weiszpal/fpga-floppy/README.md

# fpga-floppy
FPGA interface board to use an IBM PC floppy disk drive as any C64 comatible FDD
