weiszpal/fpga-floppy/beszamolo/appendices.tex

%----------------------------------------------------------------------------
\appendix
%----------------------------------------------------------------------------
\chapter*{Függelék}\addcontentsline{toc}{chapter}{Függelék}
\setcounter{chapter}{6}  % a fofejezet-szamlalo az angol ABC 6. betuje (F) lesz
\setcounter{equation}{0} % a fofejezet-szamlalo az angol ABC 6. betuje (F) lesz
\numberwithin{equation}{section}
\numberwithin{figure}{section}
\numberwithin{lstlisting}{section}
%\numberwithin{tabular}{section}

\section{Az eredeti 1581-es floppy meghajtó kapcsolási rajza}
\includepdf[pages=-,angle=90]{appendices/1581_schematic.pdf}

\includepdf[pages=1,angle=90, offset=0 -25, pagecommand={\section{Az interfészkártya kapcsolási rajza}}]{appendices/interface_board.pdf}
\includepdf[pages=2-,angle=90, offset=0 -25]{appendices/interface_board.pdf}

\includepdf[pages={-}, nup=1x2, scale=.8, pagecommand={\section{Az interfészkártya NYÁK-terve}}]{appendices/pcb.pdf}
