weiszpal/fpga-floppy/beszamolo/diploma.pdf

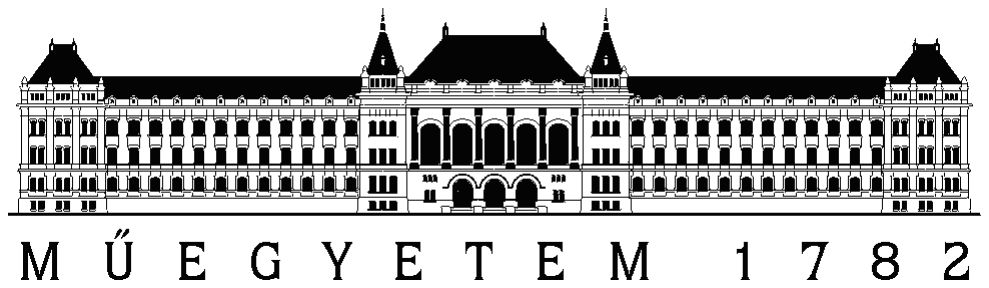
[picture p11: figure]

Budapesti M ˝uszaki és Gazdaságtudományi Egyetem Villamosmérnöki és Informatikai Kar Méréstechnika és Információs Rendszerek Tanszék

# Commodore floppy meghajtó megvalósítása FPGA-val

MSc Önall ´ o laborat ´ | orium ´ | 2.
Készítette | Konzulens
Weisz Pál | Horváth Kristóf

2022. december 18.

Feladatkiírás

A hallgató feladata, hogy egy Commodore számítógépekhez készült floppy meghajtó egységet valósítson meg FPGA segítségével. A munka magába foglalja az eredeti hardver megismerését és annak áttervezését úgy, hogy azt az interfészáramköröket leszámítva meg lehessen valósítani modern technológiák felhasználásával. Cél még, hogy kész rendszer képes legyen valódi (azaz nem virtuális) floppy lemezek kezelésére egy PC floppy meghajtó felhasználásával.

# Tartalomjegyzék

1. Bevezet˝o | 3
2. A hardver | 8
3. Digitális tervezés | 10
4. Tesztelés, hibajavítás | 16
Irodalomjegyzék | 21
Függelék | 22

# 1. fejezet

# Bevezet˝o

### 1.1. A feladat összefoglalása

Cél tehát, hogy egy szabványos IBM PC floppy meghajtót felhasználva FPGA segítségével egy olyan hajlékonylemezes egységet valósítsak meg, mely Commodore-számítógépekkel kompatibilis és a hozzájuk való floppy-lemezeket írni-olvasni képes.
Az önálló laboratórium alatt végzett munkám során egy Commodore 1581 típusú, 3,5"-es lemezmeghajtó prototípusát készítettem el ily módon. A kit˝uzött cél megvalósításához felkutattam ez eredeti meghajtó kapcsolási rajzát, szervizkönyvét, elolvastam a konstrukcióban alkalmazott alkatrészek adatlapjait. Megismerkedtem a Commodore számítógépes környezetben alkalmazott perifériák, interfészek szabványaival, m˝uködésével is. Ezek alapján, valamint az általam használt FPGA-fejleszt˝opanel és PC-s meghajtó jelszintjeinek, tulajdonságainak figyelembe vételével megterveztem egy interfészpanelt, mely az alaplapi vezérl˝o logikát implementáló FPGA-t illeszti a fizikai környezetéhez, vagyis a meghajtó hardveregységéhez és a számítógéppel való kapcsolatot biztosító soros porthoz.
Az eredeti 1581-es vezérlését egy komplett mikroprocesszoros rendszer látja el, melyet - funkcionalitását tekintve - egy az egyben az FPGA-n szintetizálva valósítottam meg. Az ehhez szükséges verilog-modulok egy részét korábbi projektekb˝ol emeltem át, a hiányzóakat pedig én magam implementáltam.
A rendszert el˝oször modulonként, majd különböz˝o integráltsági szinteken is teszteltem, el˝oször a Xilinx ISE szimulációs környezetében, majd pedig logikai analizátorral a kész hardveren is. Az FPGA-n megvalósított rendszer alkalmas az eredeti 1581-es firmware-ének futtatására, mely bináris állomány formájában rendelkezésemre állt. A kezdeti sikeres integrációs teszteket követ˝oen processzor bels˝o állapotát nagyon körülményessé vált vizsgálni, és mivel a rendszer egy ponton érzékelhet˝oen hibára futott, másféle megközelítéssel próbálkoztam: írtam egy emulátorprogramot, mely segítségével sikerült meghatároznom és kijavítanom a készként átvett CPU implementáció hibáját. További teszteket követ˝oen számos egyéb hibát derítettem fel és javítottam ki. A félév végeztével sikerül elérnem, hogy a meghajtó képes legyen hibamentesen kommunikálni soros porton keresztül a valódi Commodore számítógéppel.

### 1.2. Rendszerterv

Els˝o lépés az irodalomkutatás volt, valamint az elinduláshoz szükséges információk összegy˝ujtése. Az eredeti meghajtó áttervezéséhez nélkülözhetetlen megismerni, hogyan m˝uködik, milyen részekb˝ol épül fel az eszköz - ebben nagy segítségemre voltak a nyilvánosan elérhet˝o dokumentációk, kézikönyvek.[11] Azért esett a választás épp a Commodore 1581 típusú floppy meghajtóra, mert ez ma is többé-kevésbé elérhet˝o kis méret˝u 3.5"-es hajlékonylemezeket használ, bels˝o felépítését tekintve pedig jól elkülöníthet˝o részekre dekomponálható, szemben például a 1541-essel.

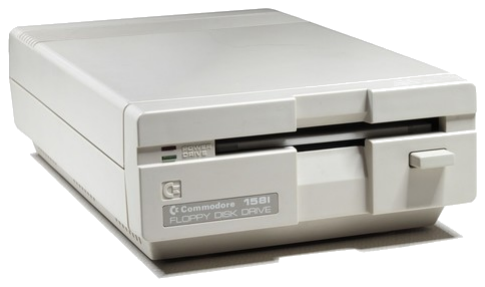
[picture p12: figure]

### 1.1. ábra. A Commodore 1581 típusú hajlékonylemezes meghajtó

A Commodore 1581-es meghajtó tulajdonképpen maga is egy "számítógép", hiszen a kiszolgálni kívánt számítógéppel való kommunikációt, és magát a lemezkezelést egy, a meghajtó alaplapján található diszkrét integrált áramköri elemekb˝ol felépített processzoros rendszer végzi. A 1581-es és a számítógép közötti kommunikáció egy Commodore IEEE-488 szabványú soros buszon zajlik.[20] A floppy lemezhez fizikailag egy bels˝o író-olvasó egység segítségével lehetséges hozzáférni, mely egyébként szabványos, Amiga számítógépeknél is használatos ún. Shugart-interfésszel rendelkezik.[5] Ezzel szemben az általam megtervezett rendszerben a floppy író-olvasó egységet egy mai modern asztali IBM PC-vel kompatibilis floppy meghajtóval helyettesítettem, mivel ilyen berendezéseket ma sem lehetetlen beszerezni, szemben az eredeti konstrukcióban alkalmazott típusúval.

A szervizkönyv mellékleteként megtalálható a meghajtó eredeti kapcsolási rajza is, melyet a további tervezéshez az alábbi részekre bontottam:

- Soros port: a soros busz meghajtását és leválasztását szolgáló áramköri elemek
- Floppy interfész: a PC floppy meghajtó illesztéséhez szükséges bufferek, inverterek
- FPGA: az egész processzoros környezetet és minden más integrált áramköri elemet a szükséges kiegészít˝o logikákkal együtt ezen fogok megvalósítani

Így jól elkülöníthet˝ové váltak azok a részek, melyekhez kiegészít˝o áramkör fizikai elkészítése szükséges az egyes protokollok tulajdonságainak ismeretében.

### 1.3. Protokollok

Következ˝o feladat annak az el˝okészítése volt, hogy az itt ismeretetett protokollokon szabványos módon történjen kommunikáció az alaplap és a PC floppy-meghajtó, valamint a számítógép között.

### 1.3.1. A Commodore IEEE-488 soros busz

A 8-bites Commodore asztali számítógépek az ún. Commodore IEEE-488 soros busz (vagy röviden IEC-busz) segítségével kommunikálnak a hozzájuk kapcsolt f˝obb perifériákkal, jellemz˝oen nyomtatókkal vagy mágneses adathordozó alapú háttértárakkal. Eredetileg az IEEE-488 szabványból alakították ki a költségek csökkentése végett (innen az elnevezése). Ez alapvet˝oen egy fél-duplex szinkron soros adatátviteli interfész, viszont számos speciális megoldást alkalmaz a szabvány pl. handshake vagy a buszra kapcsolódó eszközök jelenlét-érzékelésének megvalósítására.[20]

### 1.1. táblázat. Az IEC-busz jelei

Pin | Jelölés | Funkció
1 2 3 4 5 6 | SRQ GND ATN CLK DATA RESET | Service Request In Ground Serial Attention In/Out Serial Clock In/Out Serial Data In/out Serial Reset

Alacsony-aktív, nyitott kollektoros meghajtású vonalak ezek, 5V-os logikai jelszinttel. A számítógépez csatlakoztatott eszközöknek saját maguknak kell gondoskodniuk a tápellátásukról. Az egyes adatvonalakat mindkét végükön felhúzó ellenállások zárják le, a buszt nyitott kollektoros inverterek hajtják meg. Csatlakozó gyanánt 6 lábú DIN dugót alkalmaznak.
A soros buszra több eszköz is csatlakozhat, ezeket fizikailag daisy-chainelve lehetséges összekapcsolni egymással és a számítógéppel, emiatt szokásosan két csatlakozót építenek ki az egyes perifériákra. Az egyes eszközöket azonosítójuk alapján képes megcímezni a számítógép. Az adott azonosító DIP kapcsolók segítségével hardveresen konfigurálható, mely lemezmeghajtók esetén tipikusan 8 és 11 közötti egész értéket vehet fel.
A kommunikáció egységei 8-bites adatcsomagok, melyekben a legkisebb helyi érték˝u bit található az els˝o helyen. A mintavételezés szinkron módon, a CLK jel felfutó élére történik. Ezek az adatcsomagok lehetnek vezérl˝o parancsok, vagy adatok. Vezérl˝o parancsokkal lehet a busz használatára vagy elengedésére utasítani az egyes perifériákat, vagy épp valamilyen irányú adatátvitelt kezdeményezni a megcímzett eszközzel. A vezérl˝o parancsok a buszon az ATN jel alacsony szintje mellett érkeznek mégpedig kizárólag a számítógép fel˝ol, innen lehet tudni, hogy nem egy általános adat átvitele történik.
A CLK és DATA vonalak kétirányúak, ezeket a floppy meghajtó is lehúzhatja. Ilyen módon jelzi a számítógépnek, hogy készen áll az adat fogadására vagy küldésére, de például bizonyos id˝okorláttal kiegészített nyugtázásra is használja ezt a módszert a szabvány.[6]

### 1.3.2. Floppy meghajtó

A feladat egyik nehézségét az adta, hogy a 1581-es meghajtó eredetileg másfajta floppy íróolvasót tartalmazott, mint amilyeneket az IBM-kompatibilis személyi számítógépekben használtak, használnak. Ez nem is a m˝uködési módjukban, sokkal inkább az IBM PC és a Shugart interfészek közti különbségben nyilvánul meg:[16]

1.2. táblázat. IBM/PC és Shugart interfésszel rendelkez˝o hajlékonylemez-meghajtók lábkiosztása

IBM/PC
Pin | Jelölés | Funkció
2 | REDWC | Density Select
4 | n/c | Reserved
6 | n/c | Reserved
8 | INDEX | Index
10 | MOTEA | Motor Enable A
12 | DRVSB | Drive Select B
14 | DRVSA | Drive Select A
16 | MOTEB | Motor Enable B
18 | DIR | Direction
20 | STEP | Step
22 | WDATE | Write Data
24 | WGATE | Write Enable
26 | TRK00 | Track 0
28 | WPT | Write Protect
30 | RDATA | Read Data
32 | SIDE1 | Head Select
34 | DSKCHG | Disk Change

Shugart
Pin | Jelölés | Funkció
2 | DCD | Disk Change Detect
4 | key | no pin in this position
6 | DS3 | Drive Select 3
8 | INDEX | Index
10 | DS0 | Drive Select 0
12 | DS1 | Drive Select 1
14 | DS2 | Drive Select 2
16 | MTRON | Motor On
18 | DIR | Direction
20 | STEP | Step
22 | WDATE | Write Data
24 | WGATE | Write Enable
26 | TRK00 | Track 0
28 | WPT | Write Protect
30 | RDATA | Read Data
32 | SIDE1 | Side Select
34 | RDY | Ready

Nem tüntettem fel a táblázatban, de mindenképp érdemes megjegyezni, hogy minden páratlan számú lábat a földre kötnek. Mivel a gyakorlatban szalagkábelen szokás továbbítani ezeket a jeleket, zavarvédelem szempontjából el˝onyös, ha az áthallás csökkentése végett nem jelvezetékek haladnak közvetlenül egymás mellett, hanem felváltva követik egymást a földvezetékekkel.
Hasonlóan a soros porthoz, mindkét fajta interfész esetén is 5V-os, open kollektoros meghajtású alacsony aktív jelekkel lehet találkozni, viszont nem el˝oírás, hogy az eszköz tartalmazza a felhúzó ellenállásokat. Ezek PC esetén a számítógépben, jelen megoldásban pedig a 1581-es meghajtó alaplapján találhatóak.
Megfigyelhet˝o, hogy a jelek többsége megfeleltethet˝o egymásnak.[2] PC esetén egy szalagkábelre két meghajtó kapcsolható, ezeket az A és B kiválasztójelek segítségével lehet megkülönböztetni egymástól, míg a Shugart interfészen akár 4 különböz˝o eszköz is kiválasztható a DS jelek megfelel˝ojének földre húzásával.
Szembet˝un˝o különbség ezen kívül még, hogy a Disk Change jel máshol van kivezetve a két esetben, a Density Select valamint a Ready jeleknek pedig nincs megfelel˝oje a másik csatlakozón.
A Density Select jellel kapcsolatban egymásnak ellentmondó információkat találtam kutatásom során, valahol kimenetként, máshol bemenetként használják, de mindenképp a meghajtóban használt floppy lemez adats˝ur˝uségével hozható kapcsolatba. Ennek oka, hogy fizikailag máshogy kell kezelni egy SD, egy DD vagy egy HD hajlékonylemezt.

Korszer˝u meghajtók ezt az adathordozó tokján található kivágás segítségével érzékelik, régi fajta (és f˝oleg 5.25"-es) meghajtók esetén viszont ezzel a Density Select jellel írható el˝o, milyen adatsebességgel dolgozzon a meghajtó vezérl˝oje. Az általam használt PC floppy meghajtóban például ez a jel nincs is kivezetve.[15]
A Ready jel el˝oállításához mindenképp kiegészít˝o logika megtervezése kellett, mivel a 1581-es kapcsolási rajza szerint szükség van rá. Az eredeti író-olvasó egység adatlapja alapján ez a jel akkor aktív, ha van lemez a meghajtóban és emellett megfelel˝o sebességgel forog a motor.[3] Ha forog a motor, fordulatonként egy impulzus mérhet˝o az Index jelen. Az általam használt PC-s meghajtóban ez az impulzussorozat kapuzva van, és csak akkor kerül ki a kimenetre, miután a motor elérte a megfelel˝o fordulatszámot. Ennek a felhasználásával el˝oállítható a Ready jel, hiszen hardveresen biztosított, hogy a motor csak akkor forog, ha van a meghajtóban lemez.
A Commodore 1581-es meghajtó két oldalú, 800kB kapacitású kétszeres adats˝ur˝uség˝u (double-density, DD) lemezek kezelésére alkalmas. Az így formázott lemez oldalanként 80 sávot és 10 szektort tartalmaz fizikailag, a biteket MFM kódolással tárolja a rendszer. Mivel az így formázott lemez nem IBM kompatibilis, így a mai asztali számítógépekkel nem értelmezhet˝o a tartalma. A feladatban használt PC floppy meghajtó reményeim szerint mégis tudja kezelni, hiszen az valójában csak alacsony szint˝u hozzáférést biztosít a lemezhez, a rajta lév˝o adatok feldolgozásáról az alaplapi processzoros rendszer gondoskodik.

# 2. fejezet

# A hardver

### 2.1. Bemutatom a fejleszt˝okártyát

A feladat megoldásához egy X-SP6-X9 jelzés˝u Xilinx Spartan 6 alapú FPGA-fejleszt˝okártya állt rendelkezésemre. Számos szabadon felhasználható és széleskör˝uen konfigurálható IO kivezetésén kívül el˝onye, hogy tartalmazza az általános célú fejlesztésekhez szükséges perifériákat, nyomógombokat, kapcsolókat, LED-eket. Küls˝o JTAG programozóval tölthet˝o fel rá a bitstream, de egy 16MB-os SPI flash is helyet kapott, melyr˝ol szintén elvégezhet˝o a konfiguráció. 5V-os tápellátással rendelkezik, viszont az IO lábak 3.3V-nak megfelel˝o CMOS logikai jelszinttel dolgoznak.

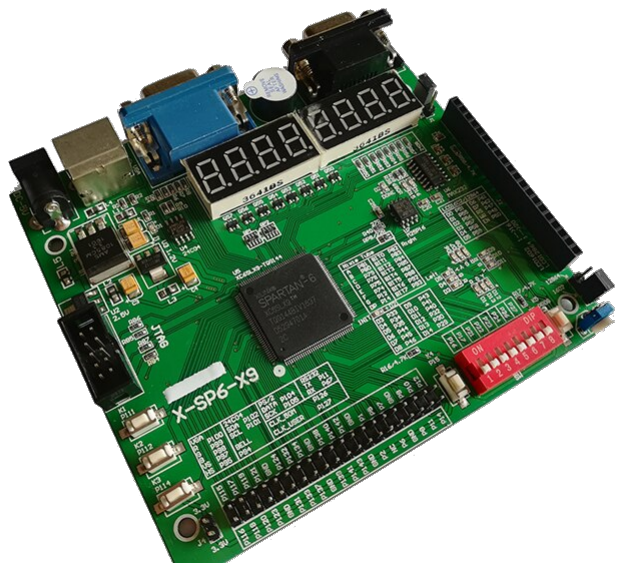
[picture p13: figure]

### 2.1. ábra. Illusztráció a megoldáshoz használt FPGA-fejleszt˝opanelr˝ol

Mivel a soros busz és az író-olvasó egységként szolgáló PC floppy meghajtó eltér˝o logikai jelszinteket használ, mint az FPGA, így mindenképp szükséges a valóságban realizálni egy szintilleszt˝o áramkört. Ezt egy interfészpanel formájában terveztem és valósítottam meg.

### 2.2. Az interfészpanel

Már a 1581-es kapcsolási rajzában is látható, hogy mind a soros port, mind a lemezmeghajtó esetén is meghajtófokozatokat, nyitott kollektoros buffereket vagy invertereket alkalmaztak, 1kΩ-os felhúzó ellenállásokkal kiegészítve. Ezeket az áramköri elemeket a szintillesztésre való tekintettel a valóságban is realizálnom kellett.
Az interfészpanel tervezésekor az eredeti terveknek megfelel˝o tulajdonságú integrált áramköri alkatrészeket választottam azzal a kritériummal kiegészítve, hogy a szükséges jelszint-illesztési feladatot is képesek legyenek ellátni. Gazdaságossági okokból, valamint az áramkör egyszer˝usítése végett az összes kimeneti vonalat 74LS06 típusú nyitott kollektoros inverterrel, a bemenetieket 5V toleráns bemenet˝u 74LVC14 típusú CMOS inverterrel kapcsoltam a rendszerhez. Ebb˝ol a megoldásból ugyan az következik, hogy az eredeti kapcsolással ellentétben néhány jel így invertáltan áll rendelkezésre, de ezek visszaállítását az FPGA-n megvalósított rendszer implementálásakor figyelembe vettem.
Az illeszt˝o áramkör kapcsolási rajza nem bonyolult, külön vettem rajta a soros porthoz és a floppy meghajtóhoz tartozó részeket, valamint helyet kapott rajta az eredeti 1581-es el˝olapján megtalálható két státuszjelz˝o LED is. Az eredeti kapcsolási rajznak megfelel˝oen a soros port kétirányú jeleit is különválasztottam.
Az áramkörnek két tápfeszültségre van szüksége, egy 3.3V-osra, és egy 5V-osra, mindkett˝ot az FPGA-fejleszt˝opanelr˝ol biztosítottam. Ehhez rendelkezésemre állt a fejleszt˝opanel kapcsolási rajza és lábkiosztása. A nyomtatott áramkört úgy terveztem meg, hogy közvetlenül illeszkedjen az FPGA-panel tüskesoraira. A huzalozás és a lábkiosztás megtervezésekor törekedtem arra, hogy a lehet˝o legkevesebb keresztez˝odéssel elférjenek egymás mellett a vezet˝osávok. Ergonómiai szempontokat is figyelembe vettem a tervezés során, hogy az FPGA-kártya kialakításának megfelel˝oen maradjon hely a programozó csatlakozó, a meghajtó azonosítójának beállítására használt DIP kapcsolók és a RESET gomb számára, és ne takarja el az interfészpanel ezeket a felületeket, miközben rajta van. Hasonlóképp helyeztem el a floppy meghajtó csatlakoztatására szolgáló IDC csatlakozót és a soros port számára a 6 lábú Tuchel aljzatot. A mechanikai kialakításkor nehézséget okozott, hogy nem volt pontos m˝uszaki rajz az FPGA-panel oldalsó tüskesorának pontos helyér˝ol, így azt becslés alapján tudtam csak pozicionálni, ez elég pontosan sikerült is.

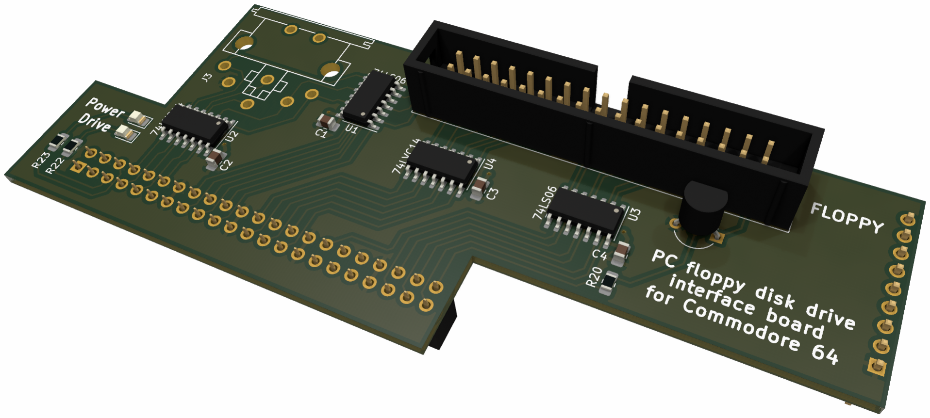
[picture p14: figure]

### 2.2. ábra. A saját tervezés˝u interfészpanel 3D terve

# 3. fejezet

# Digitális tervezés

Az FPGA-ra a Xilinx ISE 14.3-as verzójú fejleszt˝oi környezetének segítségével fejlesztettem a rendszert. Ez nem egy kimondottan korszer˝u ám szerencsére hibamentes szoftver. Azért ezt használtam mégis, mert a Spartan 6-os FPGA-kat a szoftver korszer˝u alternatívája (a Vivado) már nem támogatja. A leírófájlokat, modulokat és testbench-eket Verilog nyelven készítettem el, viszont helyenként szükséges volt VHDL-ben implementált részekkel is foglalkoznom kés˝obb a hibakeresés során.

### 3.1. Modulok

A 1581-es meghajtót egy MOS 6502 típusú processzoron futó operációs rendszer irányítja. Az alaplapon megtalálható a firmware bináris állományát tartalmazó 32kB ROM és 8kB RAM. A perifériák illesztését egy 8520-as komplex interfész adapter (CIA), a lemez író-olvasó egység vezérlését egy WD1772 típusú floppy meghajtó vezérl˝o (FDC) integrált áramkör végzi. Ezek képezik a f˝obb logikai egységeket, így kézenfekv˝o volt modulba szervezni ˝oket, és így beilleszteni a projektbe.

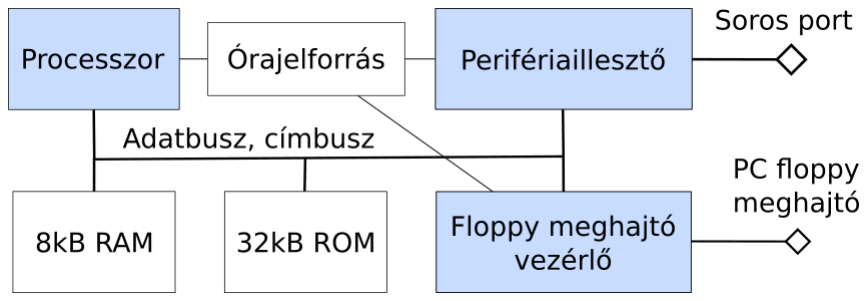
[picture p15: figure]

### 3.1. ábra. Az FPGA-n megvalósított rendszer sematikus rajza

Korábbi projektek eredményét felhasználva rendelkezésemre álltak a CPU, a CIA és az FDC implementációi, ezeket átvettem, esetenként továbbfejlesztettem munkám során. Az órajel-generátort, a RAM és ROM modulokat én készítettem el.
A rendszer 8-bites adatbuszt és 16 bites címbuszt használ, 2MHz-es rendszerórajelr˝ol jár minden a floppy vezérl˝o kivételével, mely 8MHz-es órajelet igényel. Ezen órajelek el˝oállítása egy 4-bites számlálóval történt eredetileg, egy 16MHz-es oszcillátor jelének leosztásával. Érdekesség, hogy az ehhez alkalmazott 74LS93-as IC konfigurálható bitszámú: 3 vagy 4 bites számlálót is lehetséges kialakítani a segítségével. Egy ebben a témában végzett korábbi próbálkozás során a nem megfelel˝o konfiguráció jelenthetett hibalehet˝oséget.
Az eredeti kapcsolásban az egyes logikai egységekhez tartozó címdekódolást és engedélyez˝o jelek el˝oállítását kombinációs hálózattal kiegészített multiplexerek végzik, a memóriatérkép az alábbiak szerint alakul:

### 3.1. táblázat. Az 1581-es meghajtó processzoros rendszerének címtartomány-kiosztása

Eszköz | Címtartomány
RAM CIA FDC ROM | 0x0000 - 0x1FFF 0x4000 - 0x400F 0x6000 - 0x6003 0x8000 - 0xFFFF

A címdekóder leírása verilogban:

assign CSn_RAM = addr [15:13]!=3 ’ b000; | //address range: $0000 -$1FFF (U6)
assign CSn_ROM = !(rw && addr [15]); | //address range: $8000 -$FFFF (U7)
assign CSn_CIA = addr [15:13]!=3 ’ b010; | //address range: $4000 (U6)
assign CSn_FDC = !( addr [15:13]==3 ’ b011 ); | //address range: $6000 (U6)

Mivel 1581-es meghajtóban gyakran használnak nyitott kollektoros meghajtású logikai
elemeket, így kézenfekv˝o, hogy a felhasznált logikai kapuk számának csökkentése végett
huzalozott módon valósítsanak meg bizonyos logikai függvényeket. Erre az FPGA-n technológiai okokból nincs lehet˝oség, ezért a huzalozott logikájú részeket átterveztem, hogy logikai kapukkal is le lehessen azokat írni.


3.2. ábra. Részlet az eredeti meghajtó kapcsolási rajzából.

Huzalozott logikai kapcsolat megvalósítása a soros busz DATA vezetékén, és a neki megfelel˝o verilog-leírás:

assign DATA_OUT = (∼SP_OUT) || DATA_OUT_AUX || (ATN_IN && ATN_ACK );

Bizonyos VHDL modulok implementációjában el˝ofordult, hogy kétirányúként definiáltak jeleket, például az adatbusz esetén. Ennek használata nem szerencsés, mert bár a valóságban tényleg kétirányú ugyanaz a vonal, az FPGA-ra két különböz˝o irányú jelvezetékként szintetizálódik, ezért a könnyebb érthet˝oség és a többi modullal való kompatibilitás kedvéért már a leírófájlban szétbontottam két különböz˝o vezetékre. Hasonlóképp el˝ofordult ennek a fordítottja is, amikor az eredeti kapcsolás tartalmazott kétirányú adatforgalom szétválasztására használt multiplexert, melyet így el lehetett hagyni az implementációban.

### 3.2. CPU

A 6502-es CPU egy NMOS technológiával készült 8-bites processzor. Adatbusza 8 bites, címbusza 16 bites, így összesen 64kB memóriát képes megcímezni. Kevés bels˝o regisztere van: egy akkumulátor (A), két indexregiszter (X és Y) melyek különböz˝o címzési módokhoz, címeltolásra is felhasználhatók, egy stack pointer (S) egy állapotregiszter (P), és egy 16-bites programszámláló (PC). A memória (virtuálisan) 256-bájtos blokkokba, lapokba van szervezve.
A stack hardveresen rögzített helyen, az els˝o lapon, a 0x0100-as memóriacímt˝ol kezd˝odik, és 0x01FF-ig tart. Külön figyelmet érdemel még a 0x00-s memórialap (zero-page) mely gyorsabban hozzáférhet˝o, ha a parancsok dedikált címzési módú verziójával érjük el az ott tárolt változókat. Az állapotregiszter bitjei flag-ek, logikai és aritmetikai m˝uveletek eredményeivel kapcsolatos tulajdonságokat jeleznek, a szokásos el˝ojel- (N), nulla- (Z), átvitel- (C) és túlcsordulás (V) biteken kívül tartalmaz egy BCD aritmetikát
(D) és megszakításokat engedélyez˝o bitet (I), valamint egy szoftveres megszakításkérés jelzésére szolgáló flag-et is (B). A reset vektor a 0xFFFC 0xFFFD címeken található, a megszakításvektor pedig a 0xFFFE 0xFFFF címeken - ezekr˝ol a helyekr˝ol tölt˝odik be a programszámláló értéke a processzor indulásakor, illetve megszakításkérés esetén.[17] Az eredeti 6502-es processzor a ϕ0 bemeneti órajelb˝ol két másik, fázisban egymáshoz képest 90°-kal eltolt és egymással nem átlapolódó órajelet állít el˝o a rendszer többi része számára. Ezek közül a ϕ2-t használja csak az eredeti terv alapján a meghajtó, mely az eredeti órajellel megegyez˝o fázisú.
A processzor implementációját többször lecseréltem a fejlesztés során. El˝oször az eredeti MOS 6502-es processzor tranzisztor-szint˝u felépítése alapján generált verilog-modullal próbálkoztam.[10] Sajnos az automatikusan generált leírófájl monolitikus felépítés˝u és gyakorlatilag átláthatatlan, így mivel eleinte nem sikerült m˝uködésre bírni és a bels˝o jelek vizsgálata nagyon körülményesnek bizonyult, hamar lecseréltem az Arlet Ottensféle verilog-6502 core-ra.[14] Ez az implementáció az eredetivel ellentétben az FPGA-n való megvalósíthatóság és a szemléletes m˝uködés kedvéért mikroprogramozott architektúrájú, a benne található állapotgép ráadásul aszinkron m˝uködés˝u. Ebb˝ol adódóan egy speciális, impulzusszer˝u órajelet igényel, hogy a processzormag mikro-utasításai biztosan le tudjanak futni az adott órajelciklusban. Technológiai megfontolásból FPGA-s rendszereken alapvet˝oen szinkron logikai hálózatokat érdemes megvalósítani, így konzulensem javaslatára elvetettem ezt a megoldást is, és a fejleszt˝ok körében gyakran alkalmazott T-65 nev˝u 6502 processzormag-implementációt használtam a továbbiakban.[8]
Ez a modul több kimenettel is rendelkezik, mint a 6502-es processzor, a nem használt jeleket bekötetlenül hagytam. Amelyik bemeneteket a kapcsolási rajz szerint az 5V-os tápfeszültségre kell felhúzni, azokat egész egyszer˝uen logikai magas szintre kötöttem.

### 3.3. CIA

A 8520-as komplex interfész adapter (Complex Interface Adapter, CIA) IC két 8-bites IO portot, két 16-bites id˝ozít˝ot, egy valós idej˝u órát és egy dedikált soros port perifériát tartalmaz. A 1581-es alaplapján a CIA az egyedüli periféria, mely képes megszakításokat kérni, ha valamelyik id˝ozít˝oje lejár vagy valamilyen esemény következik be a nagy sebesség˝u soros porton. A megszakításkérés egyenként engedélyezhet˝o, valamint a megszakítás forrása is lekérdezhet˝o a CIA megszakításvezérl˝o regisztere segítségével. Hasonlóképp konfigurálhatók az id˝ozít˝ok, a valós idej˝u óra, és a két IO port paraméterei. A CIA A és B jel˝u IO portjaira csatlakoznak az eszköz azonosítóját kiválasztó DIP kapcsolók, a visszajelz˝o LED-ek, valamint a soros busz jelei, irány szerint különválasztva. A csak bemenetként használt lábakra visszavezettem ugyanazon láb kimeneti irányú jelének értékét, hogy egy esetleges visszaolvasáskor jelen legyen rajta a valóságnak megfelel˝o logikai érték. Érdekesség, hogy az IEC-busz jeleit az általános IO lábak segítségével is meg tudja hajtani, s˝ot alapvet˝oen a 1581-es meghajtó ezt is használja az egyébként nagyobb sebesség˝u dedikált soros periféria helyett. Ennek történelmi okai vannak, a Commodore 64-es számítógép egy tervezési hibából adódóan nem képes olyan gyorsan feldolgozni a nagysebesség˝u soros porttal küldött adatot, ahogyan az ki tudná szolgálni. Kés˝obb ezt javították, és a Commodore 128-as számítógép esetén már a soros busz SRQ jele szolgált (az eredeti specifikációtól eltér˝oen soros órajelként) a gyors átviteli protokoll használatának kiegészítésére.[4]
A valós idej˝u órát nem az eredeti rendeltetési céljának megfelel˝oen használja a meghajtó, viszont kés˝obb a firmware-rel való ismerkedés során egy érdekes tervezési megoldásra derült fény: az alaplapot kétféle különböz˝o típusú floppy vezérl˝ovel is fel lehet szerelni, ez lehet WD1770 vagy WD1772. Az alaplapon egy átkötés beültetésével vagy elhagyásával lehet jelezni a firmware számára, melyik típusú IC szerepel a kapcsolásban, hiszen a két esetben eltér˝o rutinokat kell meghívnia a processzornak.
Mivel az összes általános célú IO láb foglalt már, a valós idej˝u órát léptet˝o TOD láb vagy egy ellenálláson keresztül 5V-ra, vagy pedig a 2MHz-es rendszerórajelre kapcsolódik az átkötés jelenlétét˝ol függ˝oen. Szoftveresen ez úgy ellen˝orizhet˝o, hogy ha egy adott idej˝u szoftveres várakozás után megváltozik a valós idej˝u óra regiszterének értéke akkor ott az átkötés, egyébként nincs.
A 8520-as CIA implementációját a C64-MiSTer elnevezés˝u projektb˝ol vettem át. Ennek lényege, hogy egy egész Commodore 64 számítógép hardverleírását tartalmazza a MiSTer nev˝u nyílt forráskódú hardverkörnyezetre, melyen többféle retro számítógép és játékkonzol modern technológiákkal (FPGA) való megvalósítására terveztek [13]

### 3.4. FDC

A hajlékonylemezes meghajtó vezérl˝o (Floppy Disk Controller, FDC) egy dedikált integrált áramkör, mely a floppy író-olvasó modul vezérl˝ojeleit állítja el˝o közvetlenül, valamint ez fogadja a lemezmeghajtóról érkez˝o nyers adatokat, visszajelzéseket is. M˝uködését tekintve egy állapotgépet valósít meg, mely szoftver oldalról magas szint˝u parancsok regiszterbe írásával vezérelhet˝o.[19]
A CIA-hoz hasonló módon, ehhez az IC-hez tartozó intellectual property-t is egy kész projektb˝ol emeltem át. A Suska projekt alapvetése, hogy egy Atari ST számítógép minden alkatrészét egyesével kicserélte a fejleszt˝o az annak megfelel˝o FPGA-s realizációjára.[9] A kapcsolási rajz alapján érdekes módon vannak a floppy meghajtónak bizonyos jelei, melyek nem, vagy nem kizárólagosan az FDC chiphez vezetnek, ilyenek például a motorvezérlés vagy az írásvédettség ellen˝orzésére szolgáló vonalak. Az is el˝ofordul, hogy egyes kimenetek egyáltalán nincsenek is bekötve az IC-n, ezeket az hardverkonfiguráció során is bekötetlenül hagytam. Abban sincs egységesség, hogy a floppy meghajtó vezérl˝ojelei közül melyik használ ponált és melyik negált logikájú digitális jeleket. Ez különös figyelmet igényelt a a top modul huzalozásakor, mivel az interfészpanelen minden jelet invertálnak a szintilleszt˝o áramkörök.
A PC-s floppy meghajtó és a meghajtóvezérl˝o IC közt némi kiegészít˝o logikára volt szükség a READY jel el˝oállításához. A Shugart-kiosztású meghajtók specifikációja alapján sejtettem, hogy a READY jel el˝oállítható egy SR-flipflop segítségével a motor engedélyez˝o és az INDEX jeleket bemenetként felhasználva. Ezt alátámasztotta az a tény, hogy léteznek kifejezetten arra a célra készült adapter-áramkörök, hogy PC-s floppy meghajtókat illesztenek Shugart-interfészt használó számítógépes rendszerbe.[18] Ezeken a kapcsolásokon egy 4 darab 2 bemenet˝u NOR kaput tartalmazó chip található, melynek m˝uködését a szabadon elérhet˝o NYÁK-tervek alapján visszafejtettem, és kideült, hogy valóban egy SR-flipflopot és két invertert valósít meg.
A READY jelet el˝oállító logikai függvény verilog-implementációja:

reg RDY;
initial RDY <= 1’b1;
always @(posedge clk) begin if(! rstn)
RDY <= 1’b1;
else begin
case({MOTEB , INDEX }) | //motor on? index?
2’b00: RDY <= 1’b1;
2’b01: RDY <= 1’b1;
2’b10: RDY <= RDY;
2’b11: RDY <= 1’b0;
endcase
end
end

### 3.5. Órajel-generátor

Az többi modulhoz szükséges órajeleket ezzel a modullal állítottam el˝o. 16MHz-es rendszerórajelet feltételeztem, melyet a floppy vezérl˝o egy az egyben megkapott, a többi modul számára az ebb˝ol leosztott 2MHz-es ϕ2 jelet adtam. A processzor implementációjából kihagyták az eredeti órajel-kondicionáló részt, mely a ϕ0-ból állítja el˝o a kétfázisú rendszerórajelet, de erre egyrészt nincs is szükség ebben a megoldásban, másrészt úgyis az órajel-generátor modul a felel˝os az összes szükséges órajel el˝oállításáért.
A frekvenciaosztást egy egyszer˝u bináris számláló végzi. Mivel az Arlet-féle processzorimplementációhoz aszimmetrikus órajelre volt szükség, így a 2MHz-es órajel-impulzusokat komparálással állítottam el˝o, és ezen a kés˝obbiekben sem módosítottam, mivel ugyanolyan jól m˝uködött.
A CIA implementációjának érdekes módon szüksége van egy invertált ϕ2 jelre is, ezt nem az órajel-modulban állítottam el˝o, hanem a bekötésnél vezettem rá az negált órajelet. A floppy vezérl˝o modul specifikációja szigorúan el˝oírja a 16MHz-es órajel használatát, mivel az FPGA-n való megvalósítás miatt bels˝o állapotgépének léptetéséhez és a vezérlésbe iktatott id˝ozítések pontos megvalósításához nagyobb frekvenciára van szükség, mint az eredeti hardver esetén.

### 3.6. Memóriák

A meghajtó eredeti kapcsolásában aszinkron RAM és ROM chipeket alkalmaztak, az adat- és címbusz meghajtását engedélyez˝o jeleket címdekóderrel állítják el˝o. Én szinkron logikai vezérléssel biztosítottam a hozzáférést mindkétfajta memóriához. A RAM és a ROM is bájtos szervezés˝u, azaz egy memóriacímmel egy bájt összes bitjéhez hozzá lehet férni. Ha olvassuk a memóriákat, akkor ezek a bitek kikerülnek az adatbuszra, ha írjuk a RAM-ot, bekerül az adatbuszon lév˝o bájt az adott cím˝u helyre.
Megvalósítás szempontjából tulajdonképpen mindkét memória egy-egy nagy regisztertömb. Arra kell külön figyelni, hogy amikor nincsenek megcímezve, ne hajtsák meg adatbuszt. Ez verilogban a Z logikai állapot használatával valósítható meg.
Mivel a ROM tárolja a 1581-es firmware-ét vagyis a CPU-n futó programot, így azt a rendszer konfigurálásakor bele kell azt valahogyan tölteni. Ehhez a $readmemh függvényt használtam, mely egy megadott helyen található bináris állományával inicializálja a paraméterként megadott regisztertömböt.
A bináris állomány rendelkezésemre állt, ugyanarról a weboldalról elérhet˝o, ahol a 1581-es szervizkönyvét is megtaláltam. Mivel a verilog hex fájlt vár a $readmemh paramétereként, át kellett alakítanom a bináris állományt a megfelel˝o formátumúra. Linux alatt a következ˝o bash-szkripttel végeztem ezt el:

for FILE in *. bin; do
hexdump -v -e ’ 1/1 "%02X\ n " ’ $FILE > ${FILE %.*}. mem; done

# 4. fejezet

# Tesztelés, hibajavítás

A feladat hátralev˝o részében az elkészült hardver-elemek tesztelésével, az esetleges hibák felderítésével és azok kijavításával foglalkoztam.

### 4.1. Az interfészpanel tesztje

Miután megérkezett a gyártásból az interfészpanel amit terveztem, elvégeztem az alkatrészek beforrasztását, és egy példaprojektet készítettem abból a célból, hogy magának a panelnek a m˝uködését ellen˝orizni tudjam. Ehhez elkészítettem az FPGA-panel tüskesorának hozzárendelését a verilog-modul jeleihez egy UCF-fájl segítségével. Az interfészpanel 5V-os jeleire egy próbapanel segítségével LED-eket illesztettem, melyeket a tesztprojektben sorban egymás után villantottam fel, így megbizonyosodhattam a szintilleszt˝o áramkör helyes m˝uködésér˝ol. Ekkor vettem észre azt is, hogy a meghajtó foglaltságát jelz˝o zöld szín˝u státusjelz˝o LED-et fordított polaritással forrasztottam rá az interfészpanelre, mivel az alkatrészen megtéveszt˝o módon szerepelt a polaritásmegjelölés - így ezt kijavítottam. A lábkiosztás megtervezésekor törekedtem arra, hogy az FPGA panel olyan lábait használjam, melyeknek nincs alternatív funkciója, ezzel csökkentve annak a valószín˝uségét, hogy a fejlesz˝opanelen található áramköri elemek vagy perifériák módosítják az áramköröm tervezett viselkedését. A teszt során nyilvánvalóvá vált, hogy az FPGA-panel specifikációjától eltér˝o módon a P11-es lábnak más funkciója is van, mégpedig az integrált soros port TX vonalát is ez táplálja. Mivel ez nincs használatban szerencsére nem okozott gondot, csak bosszantó, hogy világít az alaplapon egy extra led, valamint ezek után kevésbé megbízható dolog pusztán a dokumentációkra támaszkodni.

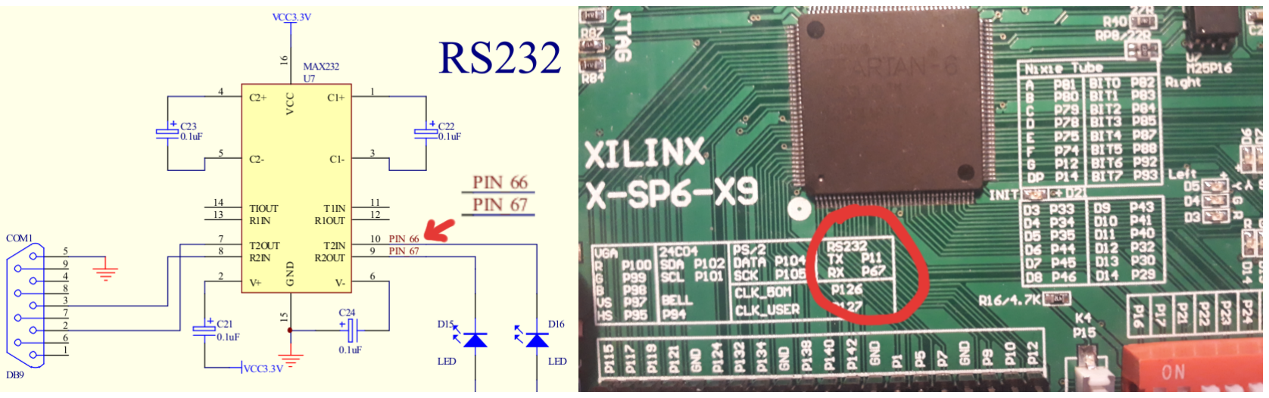
[picture p16: figure]

4.1. ábra. Eltérés a fejleszt˝opanel kapcsolási rajza és a valóság között.

### 4.2. Verilog-modulok

El˝oször a saját készítés˝u verilog-modulokhoz készítettem külön-külön tesztkörnyezeteket, és m˝uködésüket az ISE szimulátora segítségével végeztem. El˝oször az órajel-generátort, majd a memória-modulokat teszteltem, végül pedig egy olyan összeállítást is elkészítettem, ahol a RAM és a ROM is a rendszer buszaira kapcsolódik, és ellen˝oriztem az engedélyez˝o logikát valamint azt, hogy a megfelel˝o memóriacímek használatakor nem hajtanak-e szembe.
Mivel úgy t˝unt, hogy helyesen m˝uködnek ezek a modulok, elkezdtem a rendszer többi részének integrációját, egyesével vettem hozzá a projekthez a processzor, a CIA és a floppy vezérl˝o implementációjának egy-egy példányait.

### 4.3. A firmware

Miután a processzor is bekerült a top modulba, a tesztelést a ROM-ba betöltött firmware bináris segítségével végeztem: a processzor ekkor már az eredeti 1581-es meghajtóra készült kódott futtatta, így biztos lehettem benne, hogy a szoftverben nincs hiba. A bináris állományt már csak azért sem lett volna érdemes piszkálni, mivel tartalmaz egy ellen˝orz˝oösszeget is, amivel a program indulásakor a ROM tartalmának sértetlenségét ellen˝orzi. Érdekes tapasztalat volt úgy fejleszteni, hogy egy hibamentes, kész szoftver alatt kellett megvalósítani azt a hardvert, mely az eredeti specifikációnak megfelel˝o m˝uködést hivatott biztosítani.
További nehézséget jelentett, hogy magának a firmware-nek a m˝uködése csak az eredeti, assemblyben megírt forrásfájlok kommentjeib˝ol, valamint egy német nyelven kommentezett dissassembly listing fájlból volt kideríthet˝o.[7] Természetesen a 1581-es meghajtó felhasználói kézikönyvében számos információ utal arra, hogyan kell m˝uködnie bizonyos esetekben a meghajtónak, a részletes okokat csak a hardver és a firmware átfogó ismeretében lehet tudni.
A szimulátor segítségével nyomon követhet˝o volt a program futása, az FPGA-panel IO lábai mellé a processzor és a rendszer bels˝o jeleit is felvettem a megjelenített hullámformák közé, így láthatóvá váltak a buszm˝uveletek, a programszámláló és a különböz˝o regiszterek értékei is. A program futása során el˝oször különböz˝o hardveres teszteket hajt végre: inicializálja a perifériákat, leellen˝orzi a ROM sértetlenségét az ellen˝orz˝oösszeg alapján, különböz˝o értékekkel tölti fel a RAM-ot majd vissza is olvassa azokat. Az ekkor fellép˝o hibajelenségeket a hiba okától függ˝oen a visszajelz˝o LED-ek megadott számú felvillanásával lehet azonosítani.
Miután lefutottak a tesztek, elalszik a ’Drive’ feliratú státusz visszajelz˝o LED, és a firmware elindít egy operációs rendszert. Az ütemez˝ot az interfész adapter Timer B id˝ozít˝oje hívja meg, másodpercenként 100-szor. Az operációs rendszer prioritásokkal megadott JOB-okat futtat, egyszerre legfeljebb 8-at képes nyilvántartani. Futáskor a JOB kódokat a prioritásuknak megfelel˝o sorrendben fix memóriacímeken tárolja, a feladat befejezésekor pedig a visszatéréskor adott kód (hibakód) kerül a helyére.

A szimuláció kezdeti szakasza alapján m˝uködni látszott a processzor, így megpróbáltam az FPGA-ra szintetizálva is kipróbálni a rendszert. Azt tapasztaltam, hogy sosem aludt el a zöld LED, és valóban nem is jutott túl az inicializálási állapoton a meghajtó. Mivel a hardveren nem állt rendelkezésre debugolásra vagy legalábbis a program futásának nyomon követésére alkalmas interfész, visszatértem a szimulációhoz. Hosszabb ideig futtatva azt, kiderült, hogy végtelen ciklusba kerül a program és egy olyan változó értékének 0-ra csökkenésére vár, amelyet a program további futása során nem módosít semmi.
Az assembly listing alapján kiderítettem, hogy a szóban forgó változó egy szoftveres várakozáshoz használt számláló, melynek értékét az id˝ozít˝o lejártával kiszolgálásra kerül˝o megszakításrutin csökkenti eggyel. A probléma, hogy nem jut sose érvényre ez a megszakítás. Mivel a jelenség okának felderítéséhez ezen a ponton már nem volt kényelmes pusztán a szimulátor környezetben vizsgált jelek alapján kitalálni, mi okozza a program futásában fellép˝o eltérést (annak tudatában, hogy a program viszont biztosan jól m˝uködne egy hibamentes hardveren), más megközelítéssel próbálkoztam.

### 4.4. Emulátor

Az ugró utasítások és ciklusok nyomon követése nagyon megnehezítette a debugolást, mivel az ISIM programban csak lineárisan követhet˝o a program futása. Ráadásul a memória tartalma csak a szimuláció végével elért állapotot tükrözi, a kurzorok állításával nem kérdezhet˝o le a szimuláció egy korábbi id˝opontjához tartozó állapot. Emiatt a változók és a stack tartalmának vizsgálata, valamint az eltérések észrevétele csak egy újabb szimuláció segítségével volt megtehet˝o, ami viszont jelent˝osen megnövelte a hibakereséssel töltött id˝ot.
Ahhoz, hogy egyáltalán a program futásának nyomon követését hatékonyabban tudjam végezni, írtam egy emulátor programot C-ben, mely a rendszer funkcionális m˝uködésének megfelel˝oen viselkedik. Léteznek ugyan online elérhet˝o 6502-es processzorhoz készült disassembler és emulátor eszközök, melyek viszont els˝osorban demonstrációs célúak, így nem b˝ovíthet˝ok vagy fejleszthet˝ok tetsz˝olegesen. Az emulátor elkészítéséhez mindenképp szükséges volt megismernem a 6502-es processzor bels˝o felépítését és m˝uködését, utasításkészletét, címzési módjait, és hogy melyik m˝uvelet milyen egyéb bels˝o állapotokat változtat meg. Ebben segítségemre volt a 6502-es processzor programozói kézikönyve[1], valamint az utasításkészlet online példákkal kiegészített interaktívan kereshet˝o változata.[12]
Az emulátor program ugyanazt a bináris állományt futtatja, mint amit a ROM-ba is betöltöttem, s˝ot felépítését tekintve a verilog-ban leírt rendszert tükrözi azzal az eltéréssel, hogy minden perifériához mint memória fér hozzá, a róluk beolvasott értékeket pedig az olvasás pillanatában állítottam el˝o a valóságnak (és a szimulációnak) megfelel˝o módon. Az emulátor segítségével tehet˝ok a programba töréspontok, de másmilyen típusú feltétel esetén megállítható a program futása, és szemléletes módon megtekinthet˝o a stack vagy a zero-page tartalma, hasonlóképp a CPU és a többi periféria regisztereié is. A hardveres megszakítás-kéréseket szintén a szimuláció és a kiváltó okok ismeretében az emulátorban szoftveresen valósítottam meg.
Az emulátor, a listing fájl, valamint papír és ceruza használatával sikerült visszakövetnem, hogy a kívánt állapot elérési láncában hol megy félre a program, és milyen értékek stack-re kerülésének köszönhet˝o, hogy ez megtörténik.
Kiderült, hogy a processzor verilog-moduljában hibás a szoftveres megszakítást jelz˝o flag implementációja, ugyanis a specifikációtól eltér˝o módon akkor is ugyanolyan értékkel kerül fel a stack-re ha hardveres megszakítás érkezik, mintha szoftveres. Fontos megjegyezni, hogy a státuszregiszterben nem változik meg sosem ennek a flag-nek az állapota, csak a megszakítás érvényre jutásakor kerül beállításra a státuszregiszter stack-re kerül˝o másolatában.
Miután megkerestem és javítottam a hibát a processzormag leírásában, a meghajtó sikeresen el tudta végezni a inicializációt a szimuláció szerint, és a valóságban is.

### 4.5. Tesztelés valódi környezetben

soros port hiba: órajel-forrás helyessége -> PLL drive nem ready -> hibás ucf fájl (dskchg és read láb megcserélve)
parancsok basic-ben tesztelés a valóságban: valódi C64 hardverrel (+hibajel kiolvasó szkript) + digitális analizátor + speckó kábelek

# Irodalomjegyzék

[1] Bluechip. Rockwell 6502 programmers reference. https://www.csh.rit.edu/~moffitt/docs/6502.html, (https://www.csh.rit.edu/~moffitt/docs/6502.html) October 2003. [Online; accessed 15-dec-2022].
[2] Thomas Brase. Floppy disk drive / bus interface. https://retrocmp.de/fdd/general/floppy-bus.htm, (https://retrocmp.de/fdd/general/floppy-bus.htm) 2022. [Online; accessed 15-dec-2021].
[3] CHINON INDUSTRIES, INC. Chinon F-354C 135TPI Double-Sided 3.5 In Specifi-

cations. URL: http://www.bitsavers.org/pdf/chinon/Chinon_F-354C_135TPI_

Double-Sided_3.5_In_Specifications.pdf. (http://www.bitsavers.org/pdf/chinon/Chinon_F-354C_135TPI_Double-Sided_3.5_In_Specifications.pdf)

[4] COMMODORE SEMICONDUCTOR GROUP, Postscript-conversion by Markku Alén. 6526 COMPLEX INTERFACE ADAPTER (CIA), February 2001. URL: http:

//archive.6502.org/datasheets/mos_6526_cia_recreated.pdf.

[5] NEC Corporation. FDI036A 3.5” FLOPPY DISK DRIVE PRODUCT DESCRIPT-

ION, 1985. URL: https://raw.githubusercontent.com/MiSTer-devel/AtariST_

MiSTer/master/rtl/fdc1772/NEC%20FD1036%20Floppy.pdf. (https://raw.githubusercontent.com/MiSTer-devel/AtariST_MiSTer/master/rtl/fdc1772/NEC%20FD1036%20Floppy.pdf)

[6] J. Derogee. IEC disected - IEC-bus documentation as used for the 1541-III, Feb-

ruary 2008. URL: http://www.zimmers.net/anonftp/pub/cbm/programming/

serial-bus.pdf. (http://www.zimmers.net/anonftp/pub/cbm/programming/serial-bus.pdf)

[7] Ninja/The Dreams. All about your 1581-online help v0.13. http://unusedino.de/ec64/technical/aay/c1581/, (http://unusedino.de/ec64/technical/aay/c1581/) 2002-2005. [Online; accessed 15-dec-2022].
[8] FreeCores. t65. https://github.com/freecores/t65, 2005. [Online; accessed 15-dec-2022].
[9] Experiment-S / Wolfgang Förster. Ein in vhdl modellierter open source ip-core

mit atari st(e) funktionalität. https://download.experiment-s.de/Configware/
2K21A/rtl/vhdl.7z, (https://download.experiment-s.de/Configware/2K21A/rtl/vhdl.7z) 2004. [Online; accessed 15-dec-2022].
[10] Andrew Holme. Verilog 6502. http://www.aholme.co.uk/6502/Main.htm, 2016.
[Online; accessed 15-dec-2022].
[11] Commodore Electronics Limited. SERVICE MANUAL 1581 3.5 DISK DRIVE, Ju-

ne 1987. URL: http://www.zimmers.net/anonftp/pub/cbm/schematics/drives/

new/1581/1581_Service_Manual_314982-01_(1987_Jun).pdf. (http://www.zimmers.net/anonftp/pub/cbm/schematics/drives/new/1581/1581_Service_Manual_314982-01_(1987_Jun).pdf)

[12] mass:werk. | 6502 instruction set. | https://www.masswerk.at/6502/6502_
instruction_set.html. (https://www.masswerk.at/6502/6502_instruction_set.html) [Online; accessed 15-dec-2022].
[13] MiSTer-devel. | C64_mister. | https://github.com/MiSTer-devel/C64_MiSTer/
tree/master/rtl/iec_drive, (https://github.com/MiSTer-devel/C64_MiSTer/tree/master/rtl/iec_drive) 2019. [Online; accessed 15-dec-2022].
[14] Arlet Ottens. verilog-6502. https://github.com/Arlet/verilog-6502, 2016. [Online; accessed 15-dec-2022].
[15] Sony Corporation. MPF920-Z 3¹/2” Floppy Disk Drive, 2004. URL: https://pro.sony/

s3/cms-static-content/operation-manual/4668278111.pdf. (https://pro.sony/s3/cms-static-content/operation-manual/4668278111.pdf)

[16] Sven Olaf Kamphuis, Malvineous, Kikinou, Peter Bye, archyx et. al. Floppy diskdrive

pinout and wiring. https://old.pinouts.ru/HD/InternalDisk_pinout.shtml,
2019. [Online; accessed 15-dec-2022].
[17] Synertek. SY6500 8-Bit Microprocessor Family. URL: https://www.princeton.edu/

~mae412/HANDOUTS/Datasheets/6502.pdf. (https://www.princeton.edu/~mae412/HANDOUTS/Datasheets/6502.pdf)

[18] toms01. | 1581-pc-drive-adapter. | https://gitlab.com/toms01/

1581-pc-drive-adapter/-/tree/master/, (https://gitlab.com/toms01/1581-pc-drive-adapter/-/tree/master/) 2020. [Online; accessed 15-dec-2022].

[19] WESTERN DIGITAL CORPORATION, Edited By Jean Louis-Guérin. WD1772 Flop-

py Disk Formatter/Controller, January 2015. URL: http://info-coach.fr/atari/

documents/_mydoc/WD1772-JLG.pdf. (http://info-coach.fr/atari/documents/_mydoc/WD1772-JLG.pdf)

[20] Wikipedia contributors. Commodore bus — Wikipedia, the free encyclopedia.

https://en.wikipedia.org/wiki/Commodore_bus, 2022. [Online; accessed 04-dec-
2022].

# Függelék

F.1. Az eredeti 1581-es floppy meghajtó kapcsolási rajza

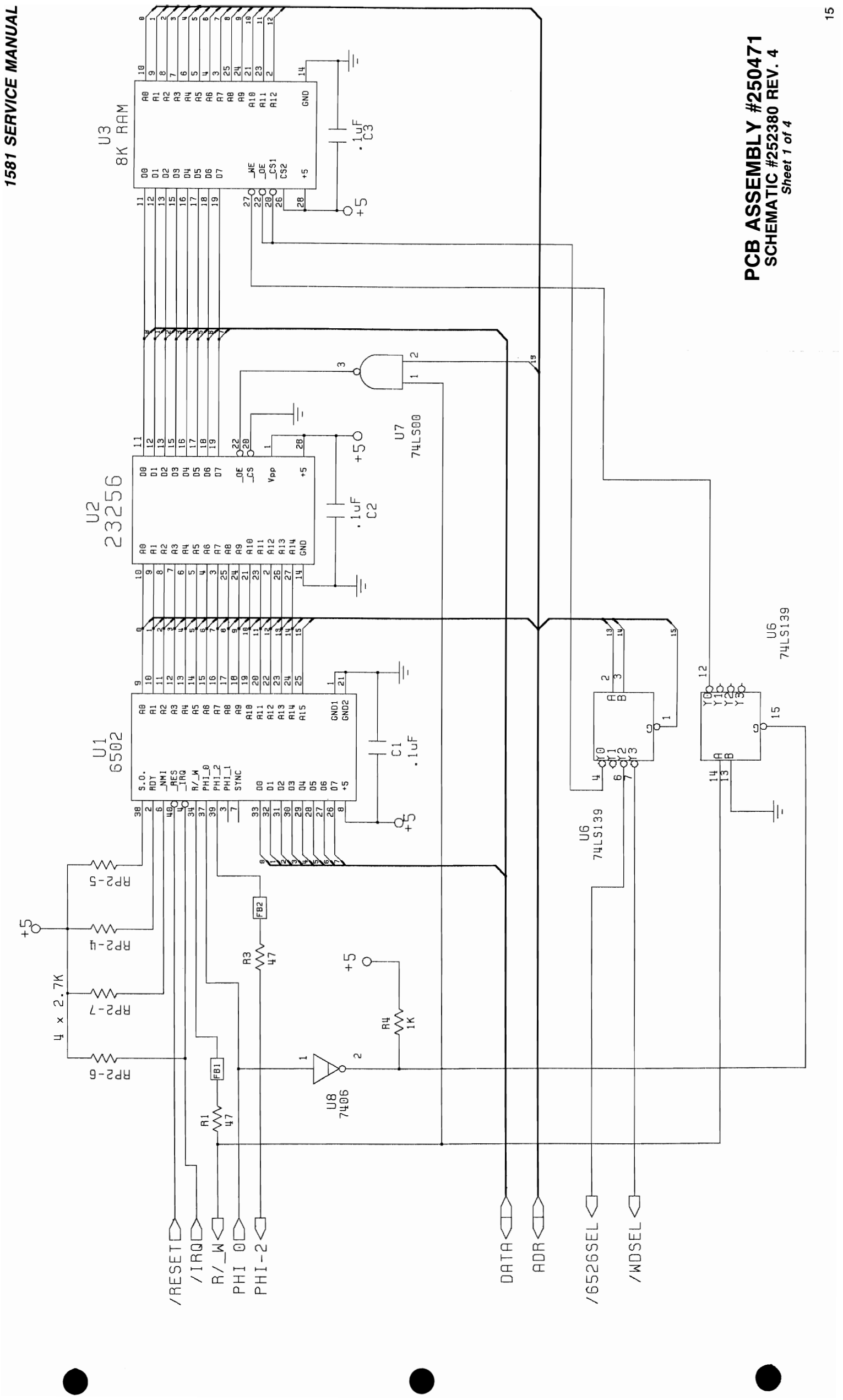
[picture p17: page 24]

•

•

•

IRE SET

IIRO
RI _W

PH I 0

### PHI-2

DRTR

RDR
165265

IWDS

----...-- <......J..-

<=c::::

EL

EL

!~ 0...-

cr:

J

RI

.II FBI

I.! 7

1

U8

74:86 )

2

+5

lJ x 2.7K

# ~~ :::r > LD

I I

~< (\J
~

cr: cr: a:

I

R3

~ 47

+5
I RI.!

" v
1K

L
l

Ul

6582

38 S.D. AG 9

2 ROT Al 18
6 _NMI A2 11

L18r _RES A3 12

## i(:: IRQ AlJ 13 - 3lJ'- R/_W AS 111

37 PHL8 A6 15

39 PHL2 R7 16

-4-- PHI_l AS 17
~ 16 SYNC A9

AIG 19
33 28 08 All 8 32 22
~ 01 A12 31 02 A13 23
38 03 All< 2l!

~ 29 04 A15 25

28 05 27 06

26 07 GNDl 1

~ .....JL. +5 GND2 21 r--=-=-

l

I I

C1 -~
+ . 1 uF -

U6

# ~8 7LlLS139

6<:d R 2

B .1

I Y3

t.:l

1

## 12 H 14 R Y1

## ~ L:J B Y~

# 1 Y: p. c..::J

()

- 15 -

1581 SERVICE MANUAL

# U2 U3 23256 8K RRM

a. 18 A8 De 11 1 1 08 AB 18 e ( .... 9 AJ 01 12 " 12 OJ Al 9 1, 2."- 8 A2 02 13 , 13 02 R2 8 2"- L'- 7 A3 03 15 ~ 15 03 A3 7 3"'" tG 6 All 04 15 " 16 Oil All 6 q" U 5 A5 05 17 " 17 05 AS 5 5..' 6."- Ii A6 06 18 " 18 06 A6 Ii 6.' 7." 3 R7 07 19 " 19 07 R7 3 7' 6." 25 A8 " AS 25 B, 9.."- 2lJ ,,22 24 ~, A9 _DE A9 10 21 Al8 ..cS 1'"'20 27 r JJE RIB 21 Ie, lL':o! 23 I'"' 22" 23 11" All _DE All I'! ...... 2 r--L 28 '- 2 12."

la.'

R12 Vpp

1..L _C51 A12

" 28 A13 C52 lll.">! 27 All! -~ 1S. ......

# ~ GNO +5 ~ - .£L +5 GNO ...lL

# "'" 1 I I I I

3 I I -~

# . 1 uF +5 ~ +5 .1uF - - C3 - C2

U7

74:LS88 1 2

./

./ /19 ./

'"
tV

IV

1V

### PCB ASSEMBLY #250471

U6 SCHEMATIC #252380 REV. 4

7lJLS139 Sheet 1 of 4

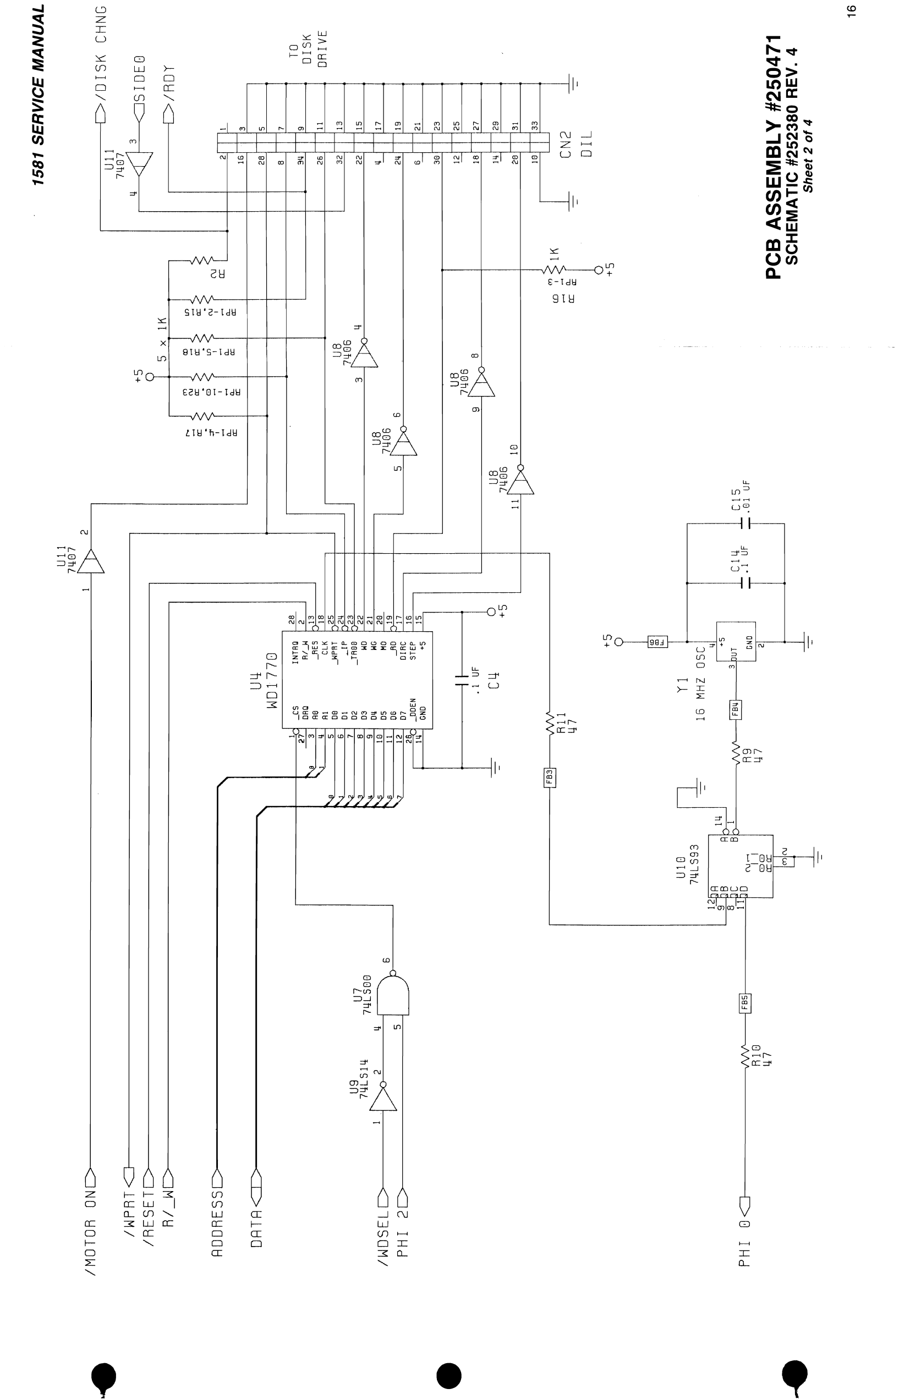
[picture p18: page 25]

•

IMOTOA
IW

IRE

R
ROOA
ORT

IWOSE
PHI

PH I 8

ON

~~:g

E55
R

L 1

2

# U9 U7 711L5111 7l!L500 .~ 2 l! .~

5 I .I

6

'------'

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
'-.s

'-s '7

_L--

FB3

# Ul8 Il 74LS93 -

!1 ~~ R~ ~ 8

~6 B 1 11 v

ru .-. R9

I I 47 88

a:: CI:

l: 0J
----.J -

U4

WD1778

### 1~ _CS INTRQ ~ ~ ORQ R/_1i t----L-

### 3 Ae RES h13 - 4, Al elK 18

5 08 _liPRT 25

6 01 _IP 24

7 02 _TRSS 23

### 8 22 03 WO 9 OY HG 21

18 20 05 MO "19 11

12

06 _RO

07 DIRe 17

25 16 _DDEN STEP

II! ~ GND +5

I I

I I

. 1 UF

[4 +5

Rll
47

+5
CD

!D
"-

Yl

16 MHZ OSC

4

+5
FBI! 3 UT

GND
2

_L--

1

U 11
71187

__ C 14 _,.... .1 UF

2

I

5
us

71186

1 1

I 1 Cl, _,.... .01 U F

d

I

0....
a::
US

7406

6 ~

9

18

+5

5 x lK

~i ~i en

ru

a:: .

0

- I I I - - - 0.... 0.... 0.... a:: a:: a::

US

71186

3 4

US

7406

B

to

..--<
a::

i

l!

~t

< 1 (Y) lK I

-Q..

a::: -

+5

1581 SERVICE MANUAL

U 11
71187

3

2r-- 1

,:-
16 f-;-3

28 --5

8 f-- 7
34 f-t-9

26 t-t- 11

32 f-f- 13

22 f-f- 15

LL f-f- 17
- - 21! 19

~ 21

30 f-f- 23

1~ f-f- 25

18 f-f- 27
I.! f-f- 29
28 f-f- 31

I

18tt33
CN2

OIL

SI

IR

I5K CHNG

OE8
OY

TO

DISK

DRIVE

-----'-----

### PCB ASSEMBL V #25 0471

V. 4 SCHEMATIC #252380 RE

Sheet 2 of 4

16

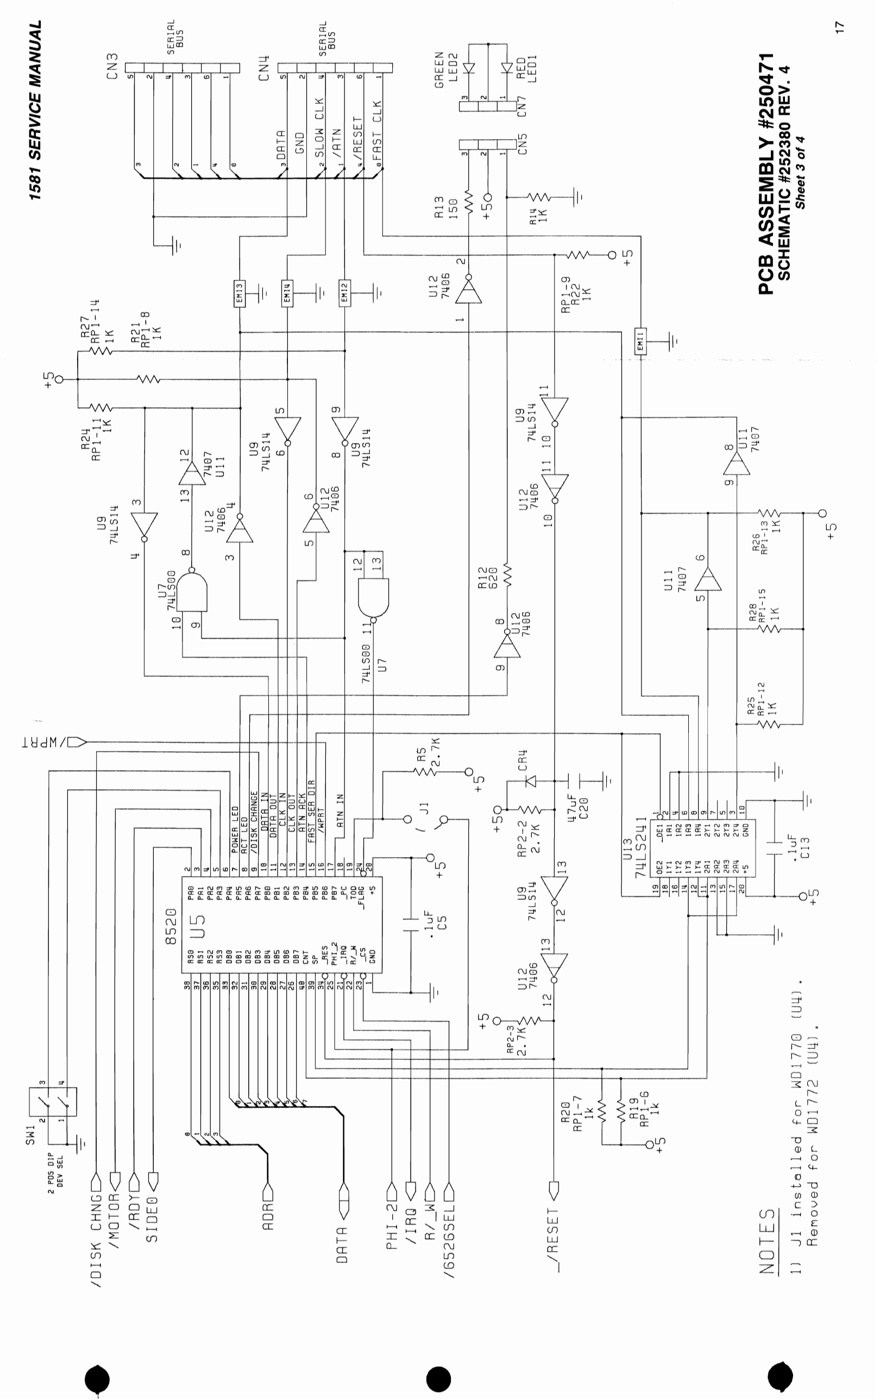
[picture p19: page 26]
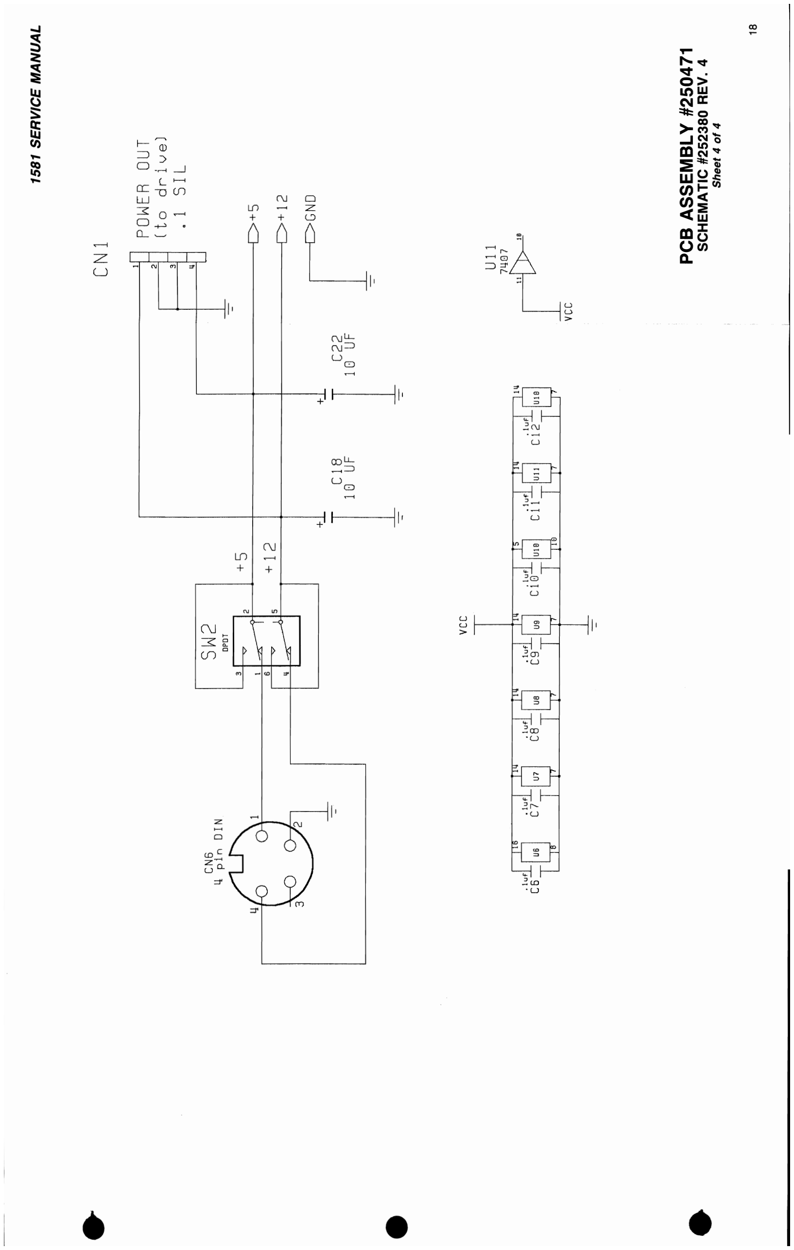
[picture p20: page 27]

•

S~2 eN6
II pin DIN OPOT

2 +5 3

6 +12

+

•

vee

•

+

C18 C22

18 UF 10 UF

tl

vee

1581 SERVICE MANUAL

CNl

2

3

U 11
7487

## POWER OUT

(to driveJ
. 1 5 I L

+5

+12
GND

### PCB ASSEMBL V #250471

SCHEMATIC #252380 REV. 4

Sheet 4 of 4

18

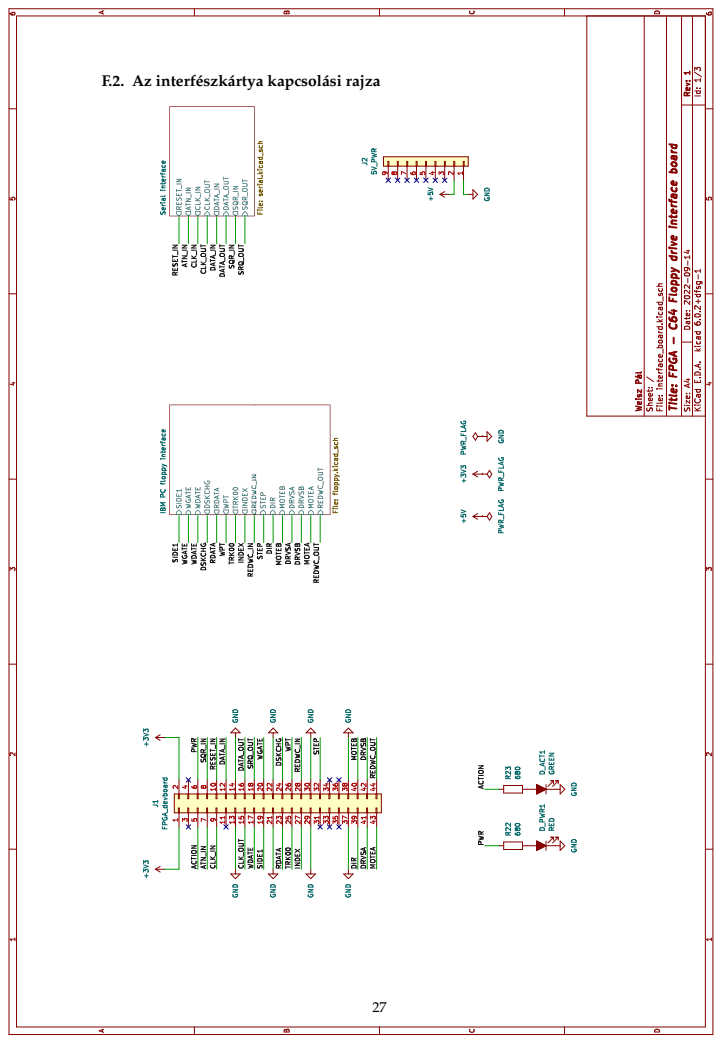
[picture p21: page 28]

F.2. Az interfészkártya kapcsolási rajza

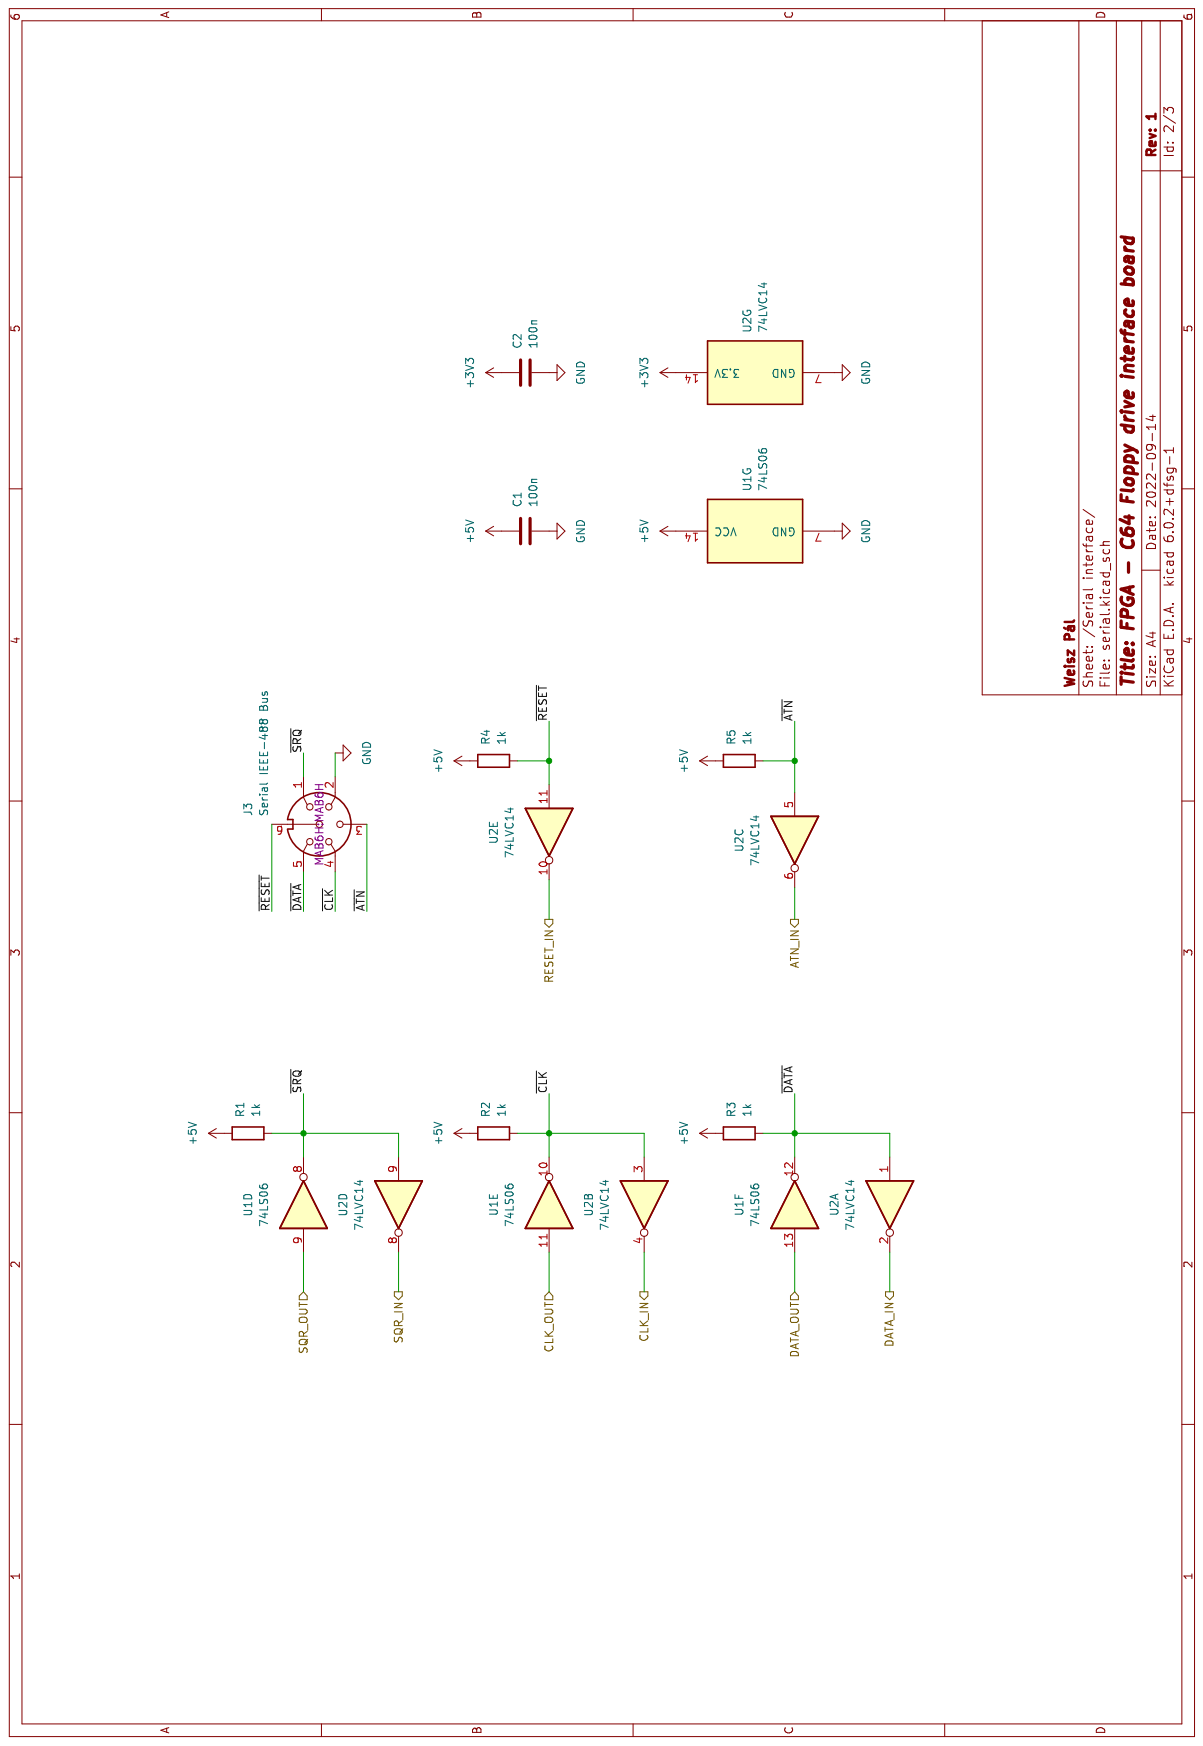
[picture p22: page 29]

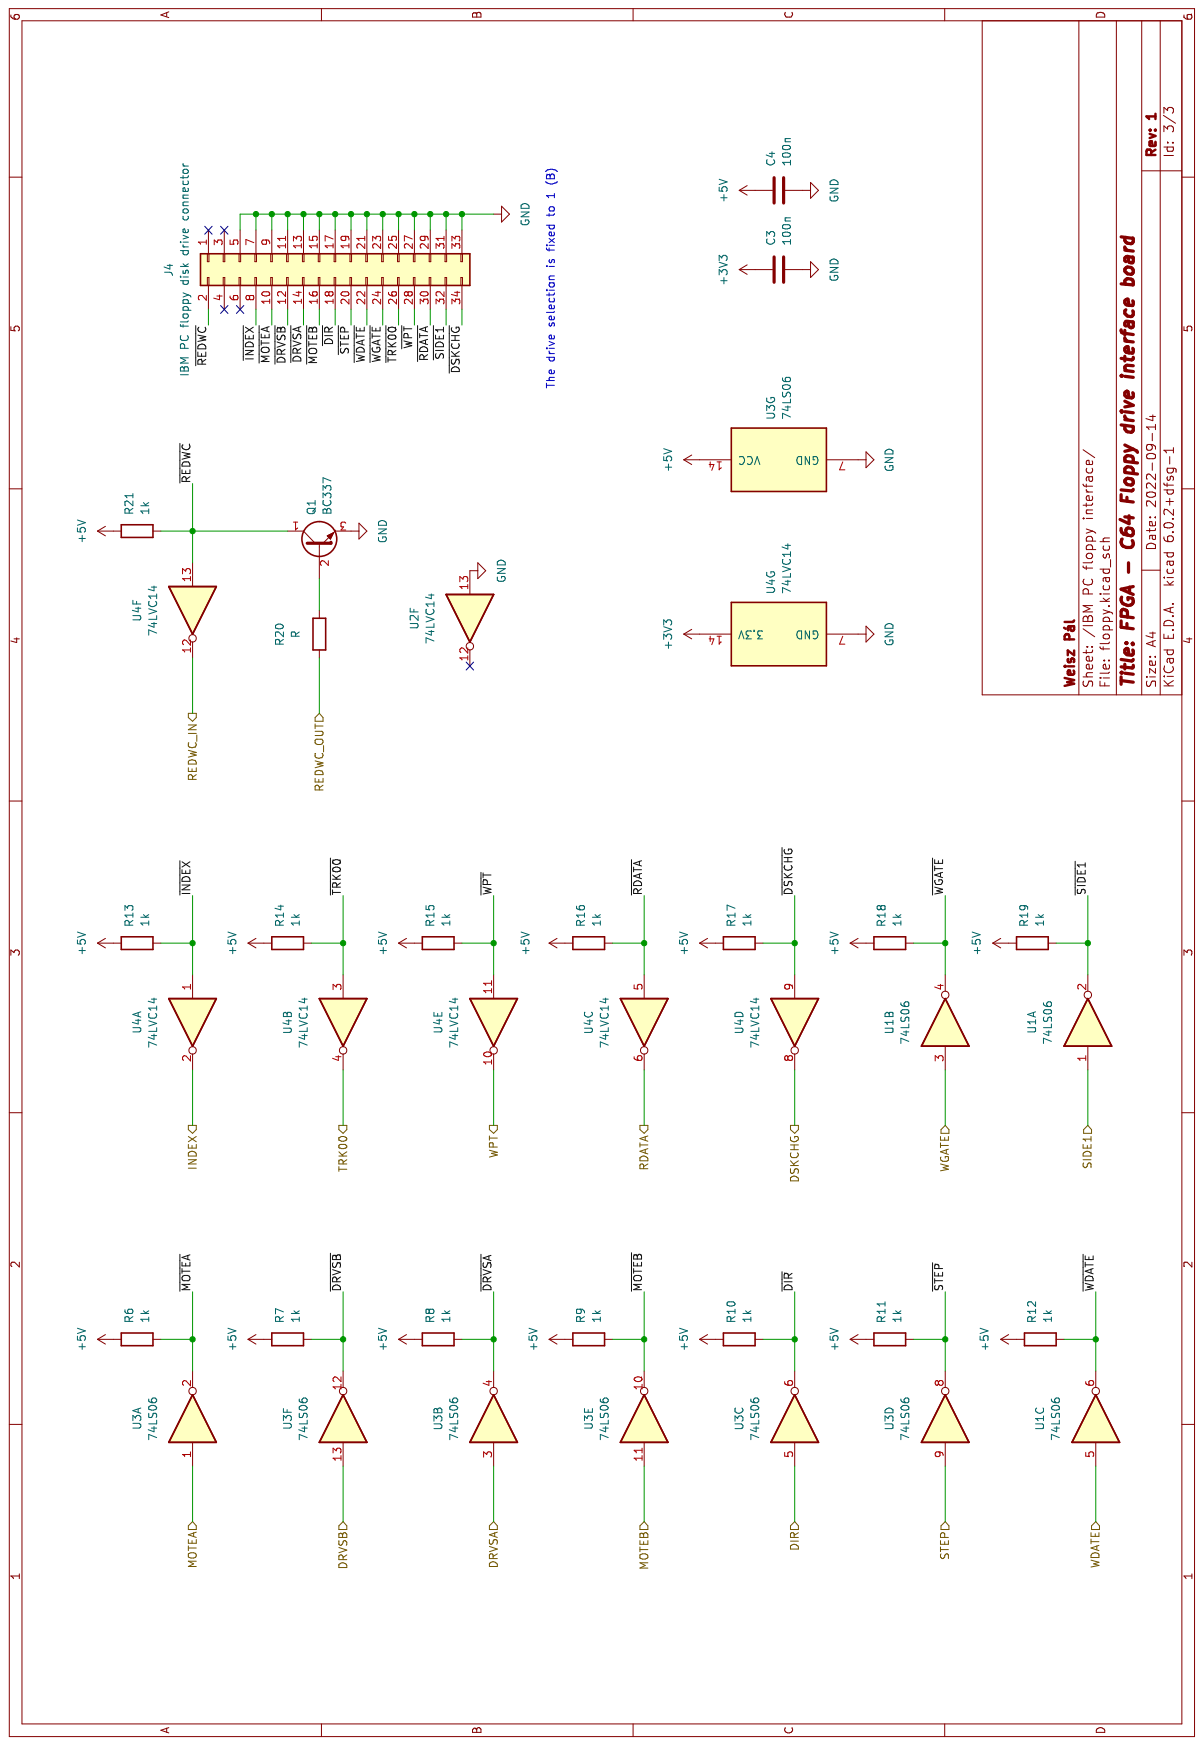
[picture p23: page 30]

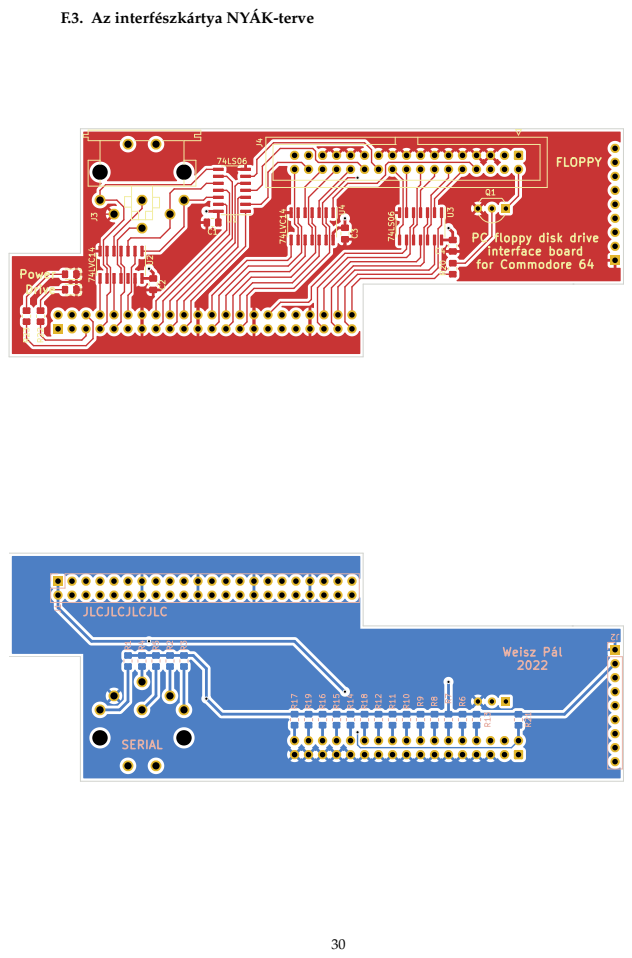
[picture p24: page 31]

F.3. Az interfészkártya NYÁK-terve
