weiszpal/fpga-floppy/beszamolo/Weisz_Pal_bem.pdf

BME VIK

Budapesti Műszaki és Gazdaságtudományi Egyetem
Villamosmérnöki és Informatikai Kar

MSc Önálló laboratórium 2.

# Commodore floppy meghajtó megvalósítása FPGA-val

Készítette: Weisz Pál
Konzulens: Horváth Kristóf
1 | 2022.12.12. | Weisz Pál - MSc Önálló laboratórium 2. Commodore floppy meghajtó megvalósítása FPGA-val

Villamosmérnöki és Informatikai Kar

## Bevezetés, célok

- Eredeti hardver megismerése, áttervezése, interfészáramkör elkészítése
- Alaplapi logikai egységek átültetése FPGA-ra, tesztelés, hibajavítás
- Tapasztalatszerzés FPGA-alapú rendszerek tervezésében

Commodore 1581 típusú

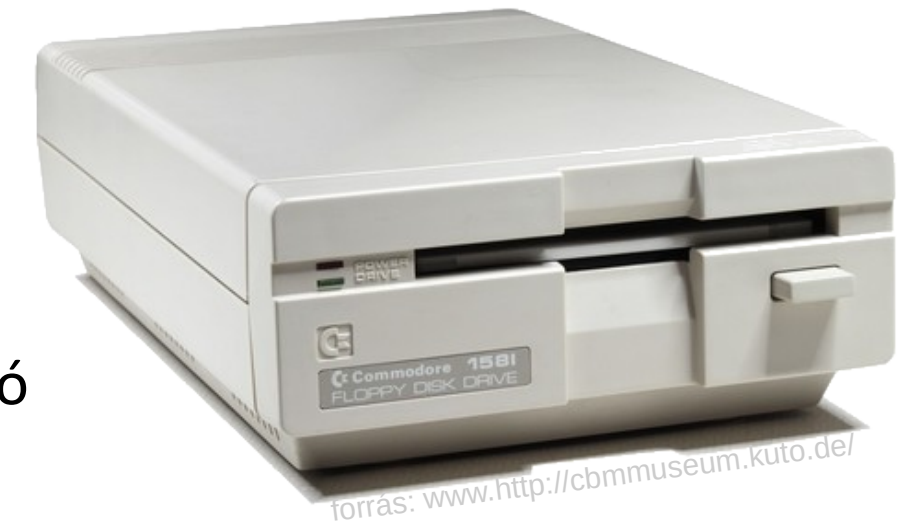
[picture p25: figure]
forrás: www.http://cbmmuseum.kuto.de/

hajlékonylemezes meghajtó

2 | 2022.12.12. | Weisz Pál - MSc Önálló laboratórium 2. Commodore floppy meghajtó megvalósítása FPGA-val

Villamosmérnöki és Informatikai Kar

## Kutatás

- Hogyan épül fel az eredeti eszköz
- Alkalmazott kommunikációs protokollok, szabványok megismerése
- Alkatrészek adatlapjai, leírások, útmutatók

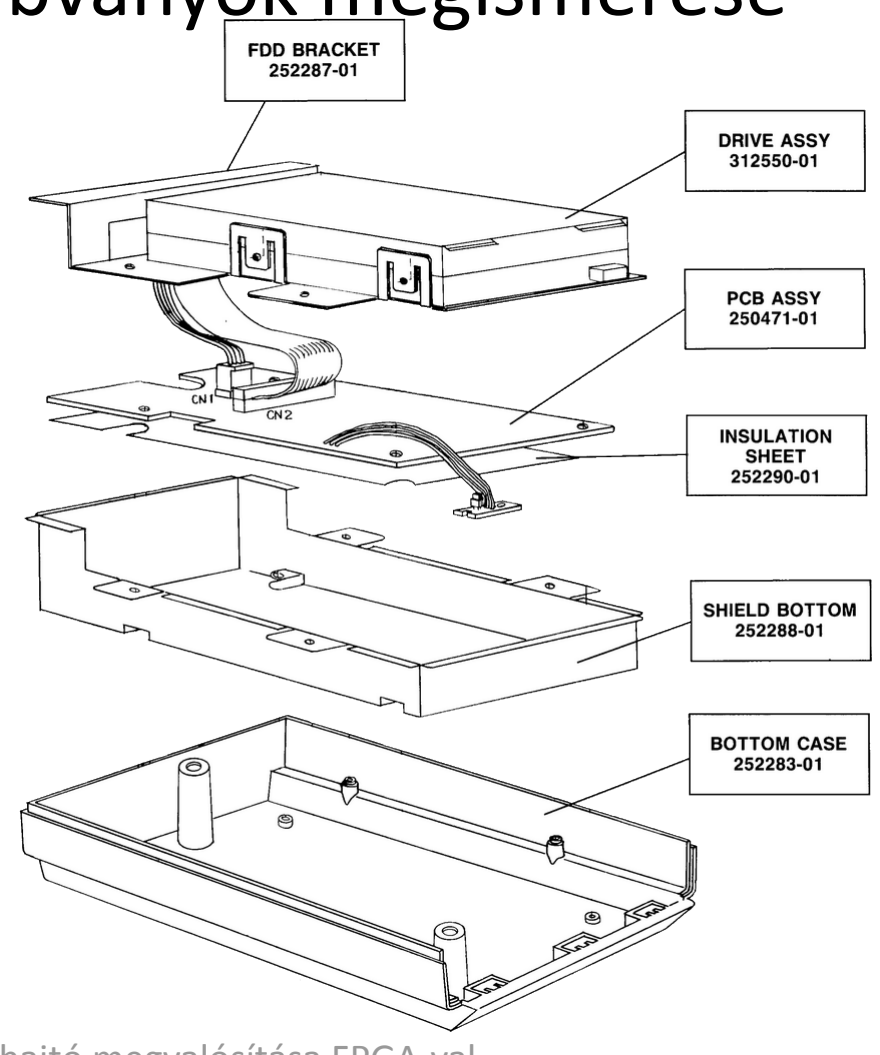
[picture p26: figure]
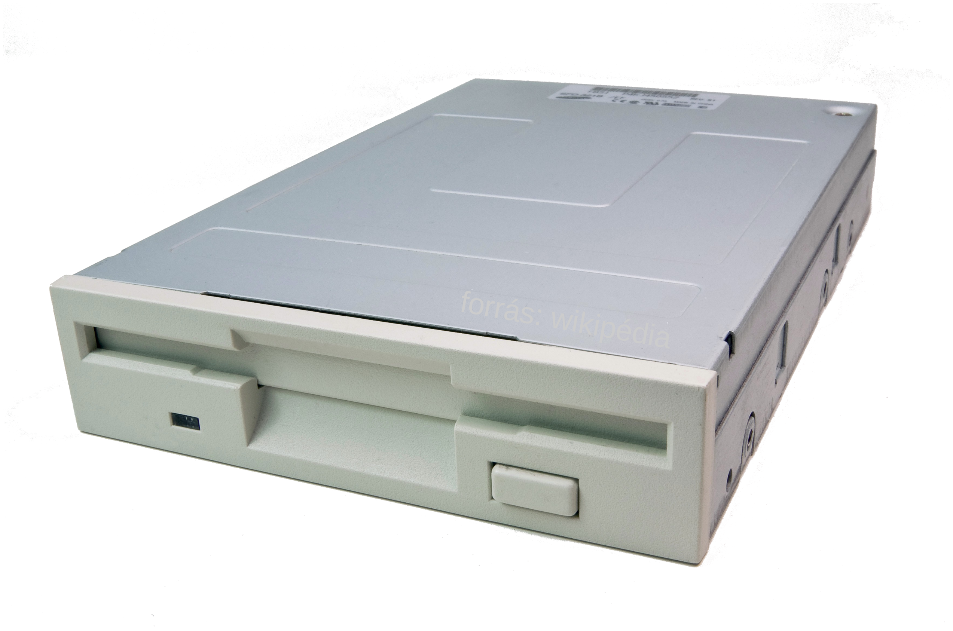
[picture p27: figure]
forrás: wikipédia

3 | 2022.12.12. | Weisz Pál - MSc Önálló laboratórium 2. Commodore floppy meghajtó megvalósítása FPGA-val

## Hardverterv

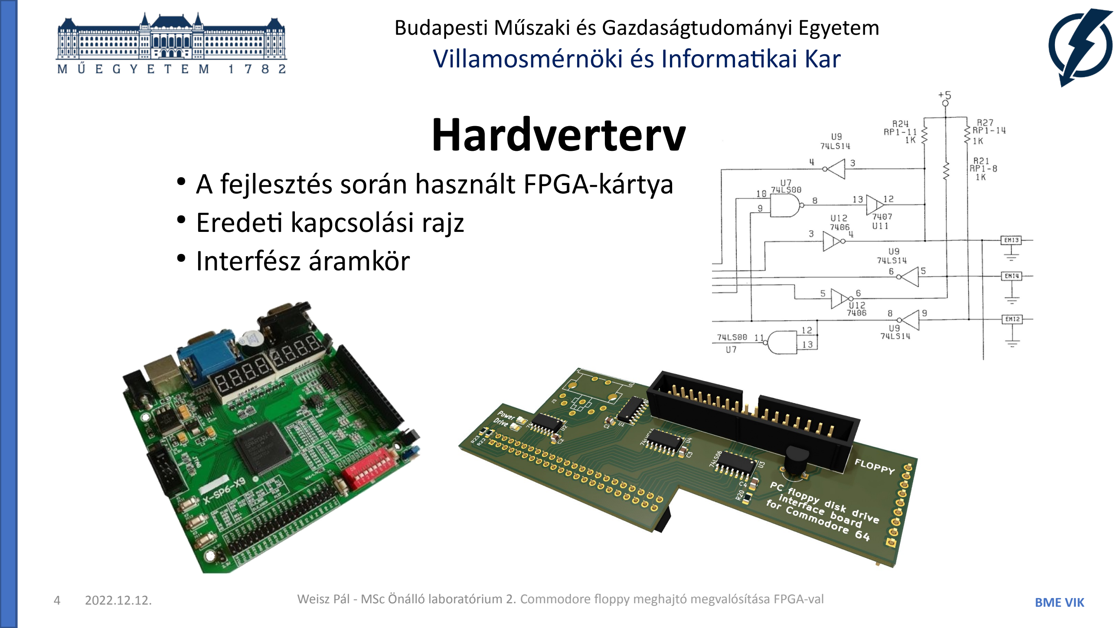
[picture p28: page 4]

Villamosmérnöki és Informatikai Kar

- A fejlesztés során használt FPGA-kártya
- Eredeti kapcsolási rajz

●

Interfész áramkör

4 | 2022.12.12. | Weisz Pál - MSc Önálló laboratórium 2. Commodore floppy meghajtó megvalósítása FPGA-val

Villamosmérnöki és Informatikai Kar

## Fejlesztés az FPGA-ra

- Korábbi eredmények felhasználása (modulok, firmware)
- Feladatok, kihívások

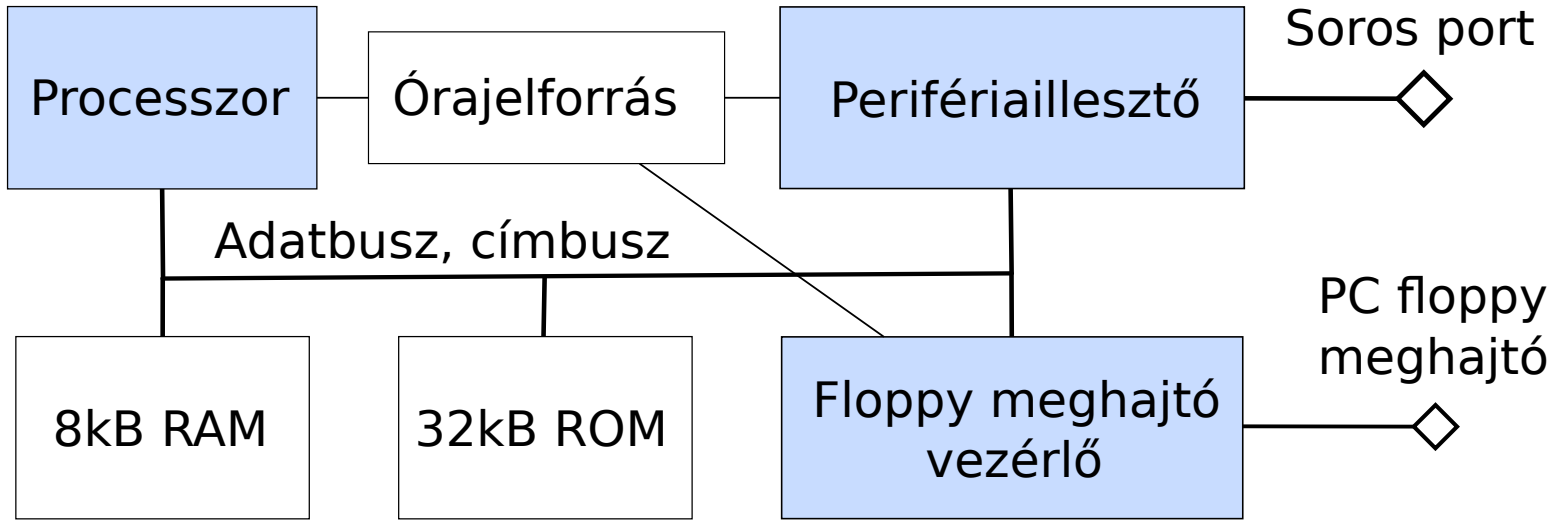
[picture p29: figure]
Processzor; Floppy meghajtó vezérlő 8kB RAM; Órajelforrás; 32kB ROM; Soros port; Adatbusz, címbusz; PC floppy meghajtó; Perifériaillesztő

5 | 2022.12.12. | Weisz Pál - MSc Önálló laboratórium 2. Commodore floppy meghajtó megvalósítása FPGA-val

## Tesztelés

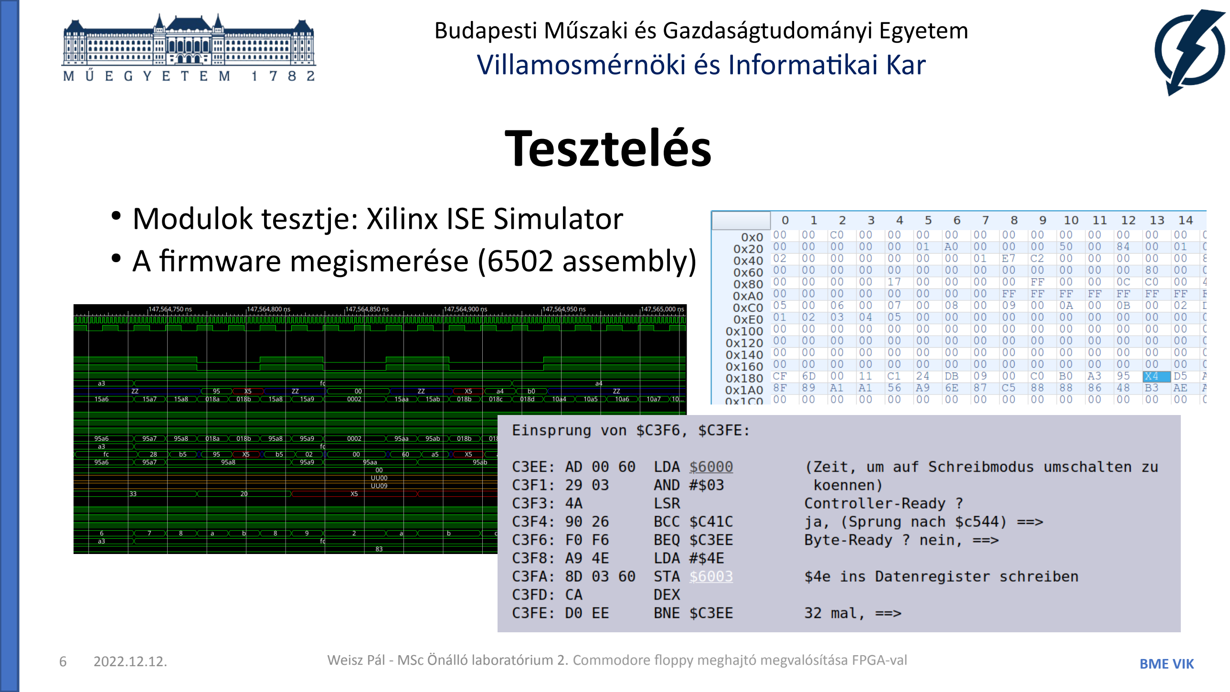
[picture p30: page 6]

Villamosmérnöki és Informatikai Kar

6 | 2022.12.12. | Weisz Pál - MSc Önálló laboratórium 2. Commodore floppy meghajtó megvalósítása FPGA-val
- Modulok tesztje: Xilinx ISE Simulator
- A firmware megismerése (6502 assembly)

## Hibakeresés, hibajavítás

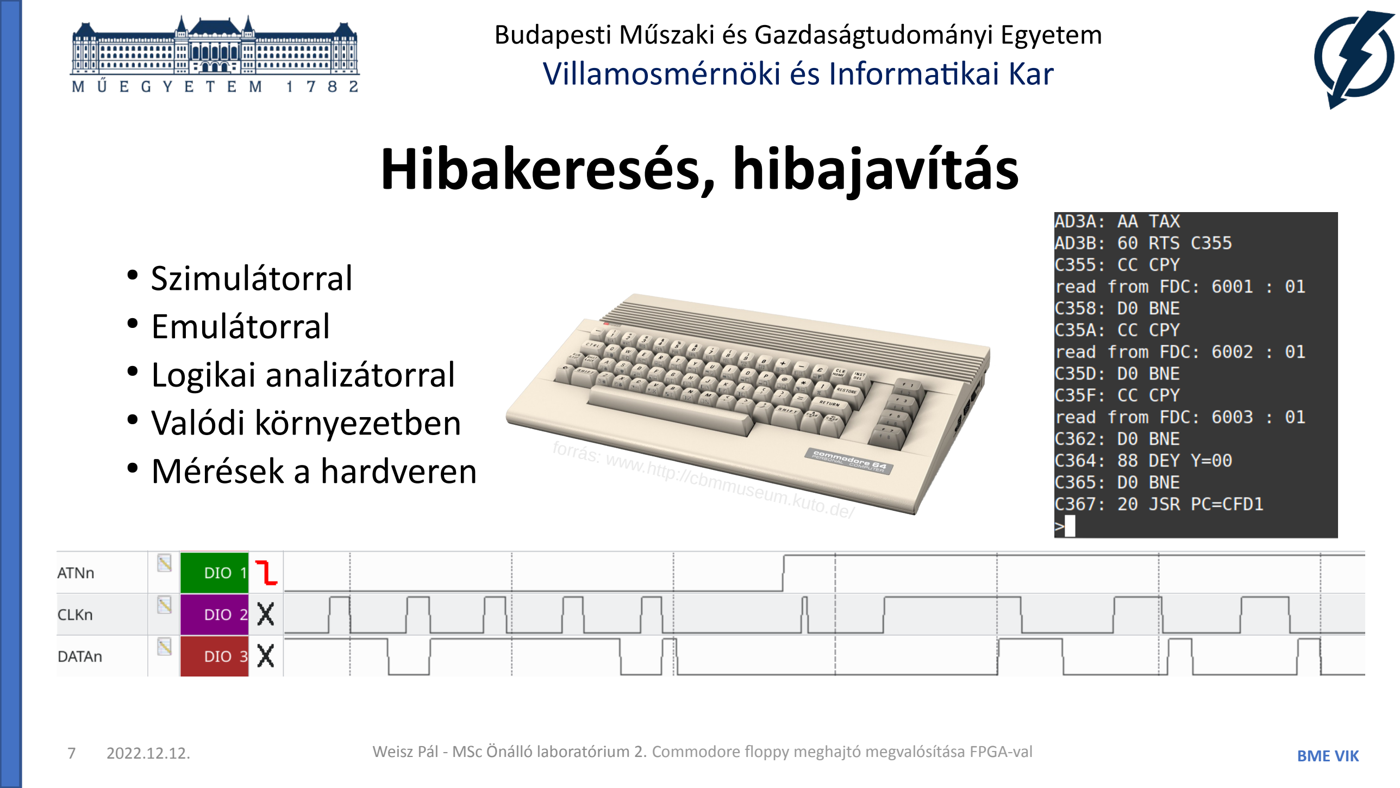
[picture p31: page 7]

Villamosmérnöki és Informatikai Kar

7 | 2022.12.12. | Weisz Pál - MSc Önálló laboratórium 2. Commodore floppy meghajtó megvalósítása FPGA-val
- Szimulátorral
- Emulátorral
- Logikai analizátorral
- Valódi környezetben
- Mérések a hardveren

forrás: www.http://cbmmuseum.kuto.de/

Villamosmérnöki és Informatikai Kar

## Eredmények

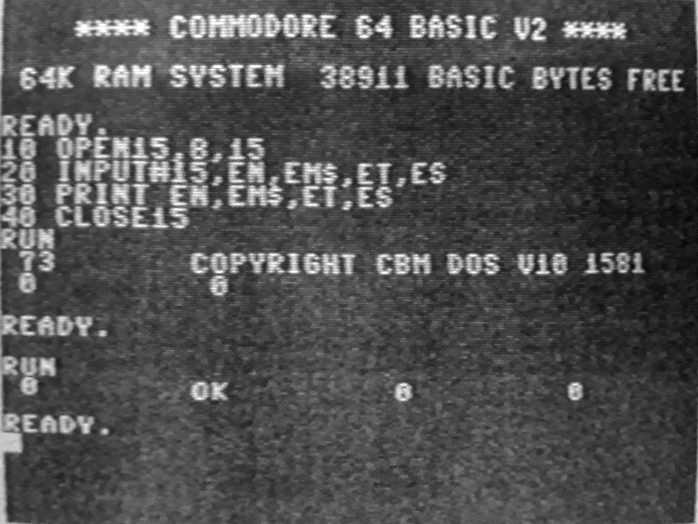
[picture p32: figure]

8 | 2022.12.12. | Weisz Pál - MSc Önálló laboratórium 2. Commodore floppy meghajtó megvalósítása FPGA-val
- Interfész panel
- Új Verilog-modulok, test bench-ek
- Emulátor program
- Javított hibák a korábbi implementációban
- Rengeteg mérés
- A PC és a meghajtó között megfelelően működik a soros kommunikáció
- Valahol még van egy bug...

Villamosmérnöki és Informatikai Kar

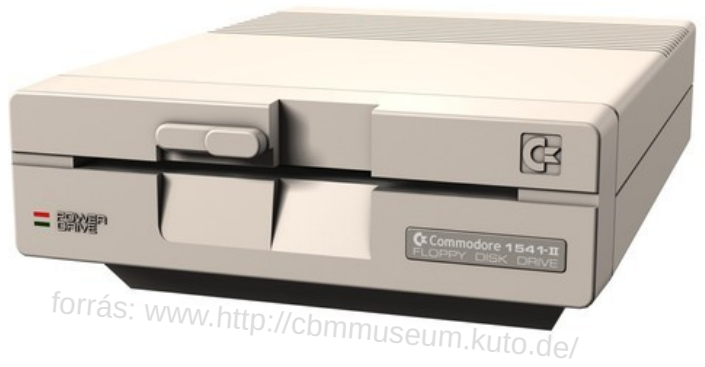
[picture p33: figure]
forrás: www.http://cbmmuseum.kuto.de/

9 2022.12.12.

- Hibakeresés folytatása
- Eszközt készre tervezni
- Másféle meghajtókat
megvalósítani

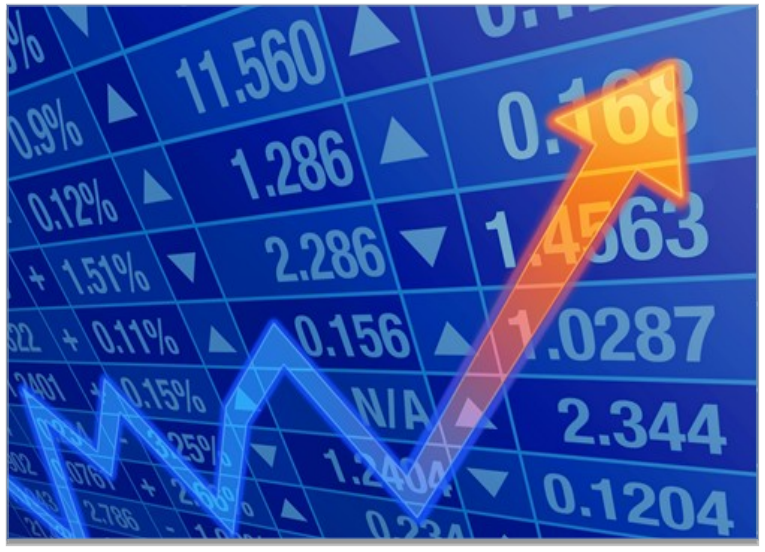
[picture p34: figure]

Weisz Pál - MSc Önálló laboratórium 2. Commodore floppy meghajtó megvalósítása FPGA-val

## További lehetőségek

Villamosmérnöki és Informatikai Kar

# Köszönöm a figyelmet!
