weiszpal/fpga-floppy/(list of files, cad)

Other CAD files:
firmware/source/SERLIB.OBJ
