weiszpal/fpga-floppy/measurements/sdrive_readstatus.csv

ATNn | CLKn | DATAn | datastream
1 | 0 | 1 | 0 | () 0x0
1 | 0 | 1 | 0 | () 0x0
1 | 0 | 1 | 0 | () 0x0
1 | 0 | 1 | 0 | () 0x0
1 | 0 | 1 | 0 | () 0x0
1 | 0 | 1 | 0 | () 0x0
1 | 0 | 1 | 0 | () 0x0
1 | 0 | 1 | 0 | () 0x0
1 | 0 | 1 | 0 | () 0x0
1 | 0 | 1 | 0 | () 0x0
1 | 0 | 1 | 0 | () 0x0
1 | 0 | 1 | 0 | () 0x0
1 | 0 | 1 | 0 | () 0x0
1 | 0 | 1 | 0 | () 0x0
1 | 0 | 1 | 0 | () 0x0
1 | 0 | 1 | 0 | () 0x0
1 | 0 | 1 | 0 | () 0x0
1 | 0 | 1 | 0 | () 0x0
1 | 0 | 1 | 0 | () 0x0
1 | 0 | 1 | 0 | () 0x0
1 | 0 | 1 | 0 | () 0x0
1 | 0 | 1 | 0 | () 0x0
1 | 0 | 1 | 0 | () 0x0
1 | 0 | 1 | 0 | () 0x0
1 | 0 | 1 | 0 | () 0x0
1 | 0 | 1 | 0 | () 0x0
1 | 0 | 1 | 0 | () 0x0
1 | 0 | 1 | 0 | () 0x0
1 | 0 | 1 | 0 | () 0x0
1 | 0 | 1 | 0 | () 0x0
1 | 0 | 1 | 0 | () 0x0
1 | 0 | 1 | 0 | () 0x0
1 | 0 | 1 | 0 | () 0x0
1 | 0 | 1 | 0 | () 0x0
1 | 0 | 1 | 0 | () 0x0
1 | 0 | 1 | 0 | () 0x0
1 | 0 | 1 | 0 | () 0x0
1 | 0 | 1 | 0 | () 0x0
1 | 0 | 1 | 0 | () 0x0
1 | 0 | 1 | 0 | () 0x0
1 | 0 | 1 | 0 | () 0x0
1 | 0 | 1 | 0 | () 0x0
1 | 0 | 1 | 0 | () 0x0
1 | 0 | 1 | 0 | () 0x0
1 | 0 | 1 | 0 | () 0x0
1 | 0 | 1 | 0 | () 0x0
1 | 0 | 1 | 0 | () 0x0
1 | 0 | 1 | 0 | () 0x0
1 | 0 | 1 | 0 | () 0x0
1 | 0 | 1 | 0 | () 0x0
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
