weiszpal/fpga-floppy/measurements/powerup_0.jpeg

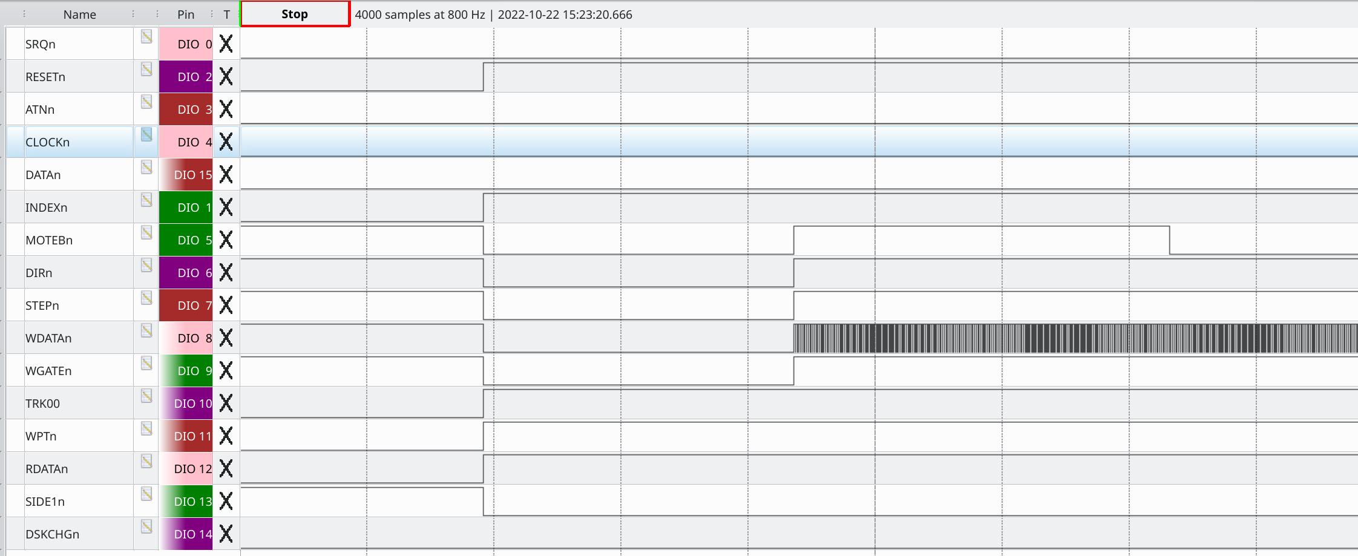
measurements/powerup_0.jpeg
