weiszpal/fpga-floppy/measurements/floppy_readstatus_bug.csv

ATNn | CLKn | DATAn | datastream | DBG_DATAUX
1 | 0 | 1 | 0 | () 0x0 | 0
1 | 0 | 1 | 0 | () 0x0 | 0
1 | 0 | 1 | 0 | () 0x0 | 0
1 | 0 | 1 | 0 | () 0x0 | 0
1 | 0 | 1 | 0 | () 0x0 | 0
1 | 0 | 1 | 0 | () 0x0 | 0
1 | 0 | 1 | 0 | () 0x0 | 0
1 | 0 | 1 | 0 | () 0x0 | 0
1 | 0 | 1 | 0 | () 0x0 | 0
1 | 0 | 1 | 0 | () 0x0 | 0
1 | 0 | 1 | 0 | () 0x0 | 0
1 | 0 | 1 | 0 | () 0x0 | 0
1 | 0 | 1 | 0 | () 0x0 | 0
1 | 0 | 1 | 0 | () 0x0 | 0
1 | 0 | 1 | 0 | () 0x0 | 0
1 | 0 | 1 | 0 | () 0x0 | 0
1 | 0 | 1 | 0 | () 0x0 | 0
1 | 0 | 1 | 0 | () 0x0 | 0
1 | 0 | 1 | 0 | () 0x0 | 0
1 | 0 | 1 | 0 | () 0x0 | 0
1 | 0 | 1 | 0 | () 0x0 | 0
1 | 0 | 1 | 0 | () 0x0 | 0
1 | 0 | 1 | 0 | () 0x0 | 0
1 | 0 | 1 | 0 | () 0x0 | 0
1 | 0 | 1 | 0 | () 0x0 | 0
1 | 0 | 1 | 0 | () 0x0 | 0
1 | 0 | 1 | 0 | () 0x0 | 0
1 | 0 | 1 | 0 | () 0x0 | 0
1 | 0 | 1 | 0 | () 0x0 | 0
1 | 0 | 1 | 0 | () 0x0 | 0
1 | 0 | 1 | 0 | () 0x0 | 0
1 | 0 | 1 | 0 | () 0x0 | 0
1 | 0 | 1 | 0 | () 0x0 | 0
1 | 0 | 1 | 0 | () 0x0 | 0
1 | 0 | 1 | 0 | () 0x0 | 0
1 | 0 | 1 | 0 | () 0x0 | 0
1 | 0 | 1 | 0 | () 0x0 | 0
1 | 0 | 1 | 0 | () 0x0 | 0
1 | 0 | 1 | 0 | () 0x0 | 0
1 | 0 | 1 | 0 | () 0x0 | 0
1 | 0 | 1 | 0 | () 0x0 | 0
1 | 0 | 1 | 0 | () 0x0 | 0
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
