weiszpal/fpga-floppy/beszamolo/appendices/interface_board.pdf

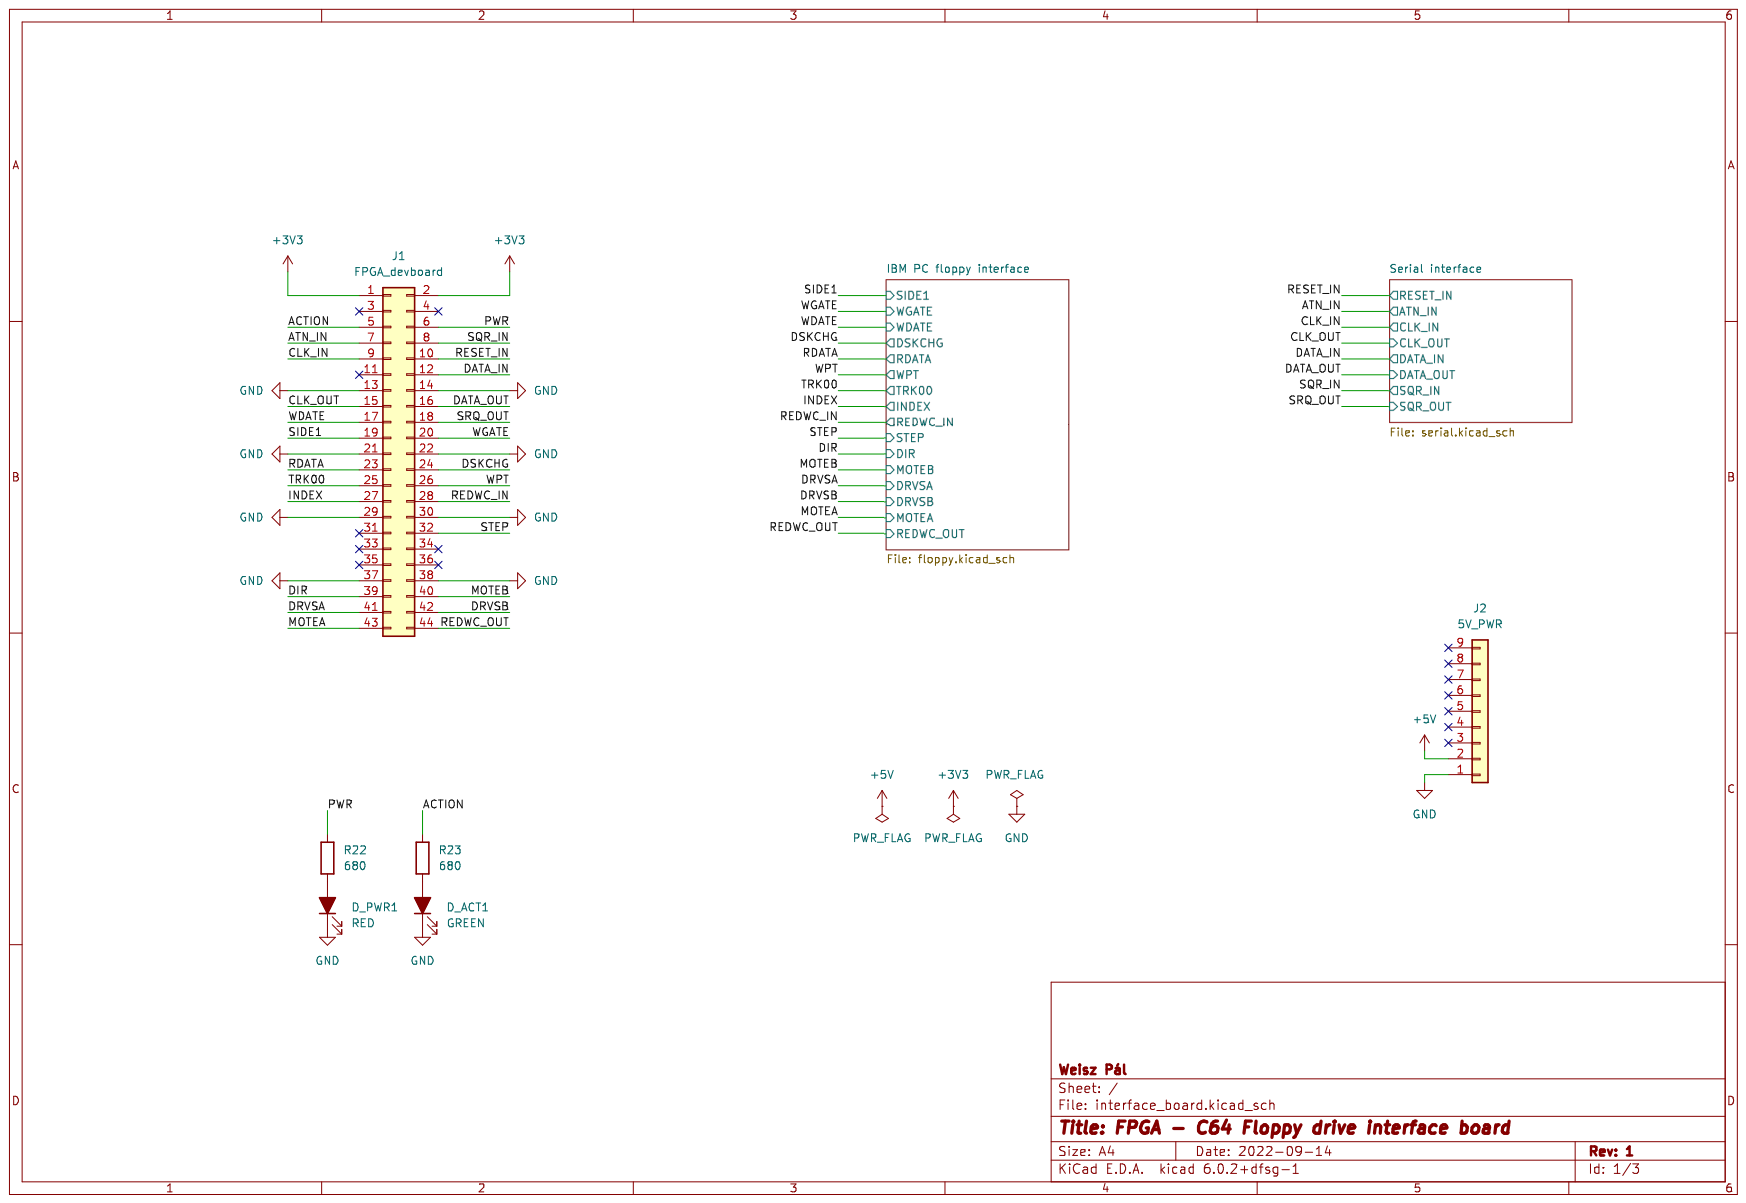
[picture p36: page 1]

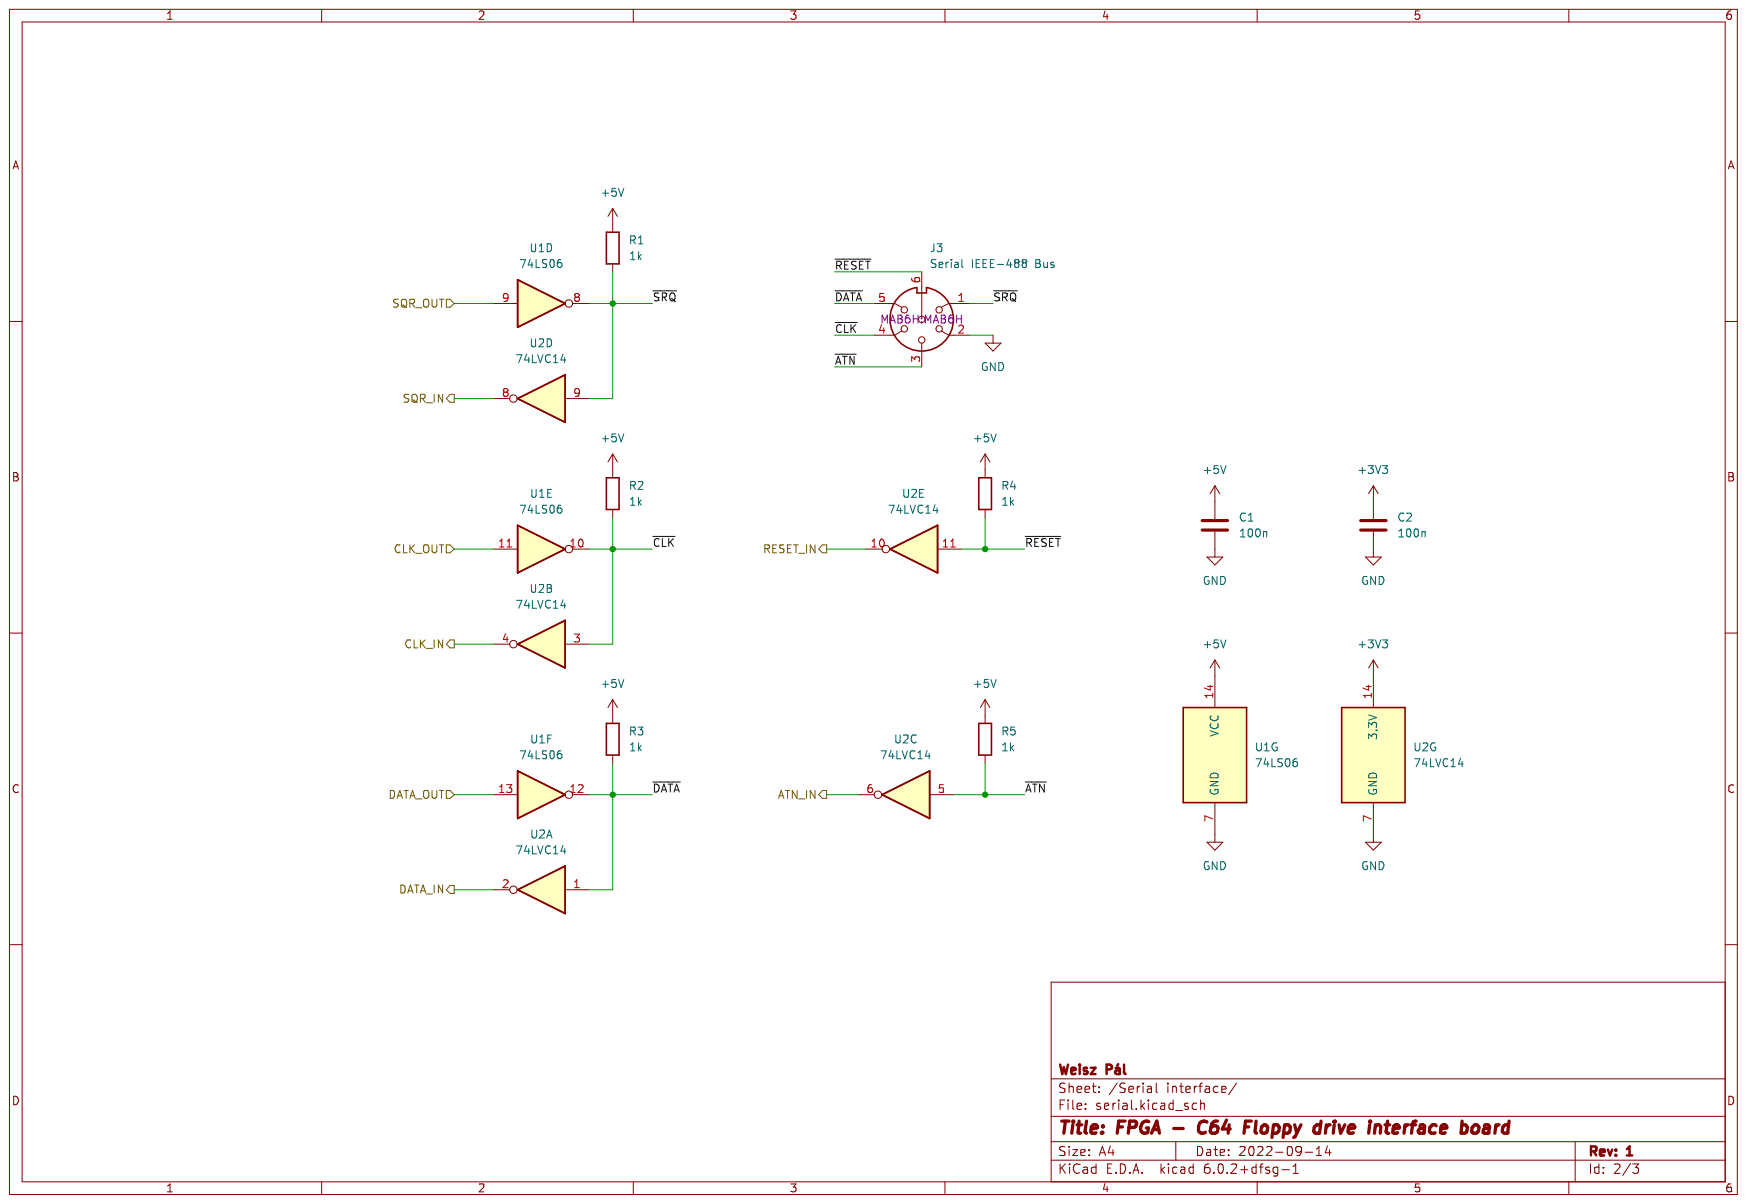
[picture p37: page 2]

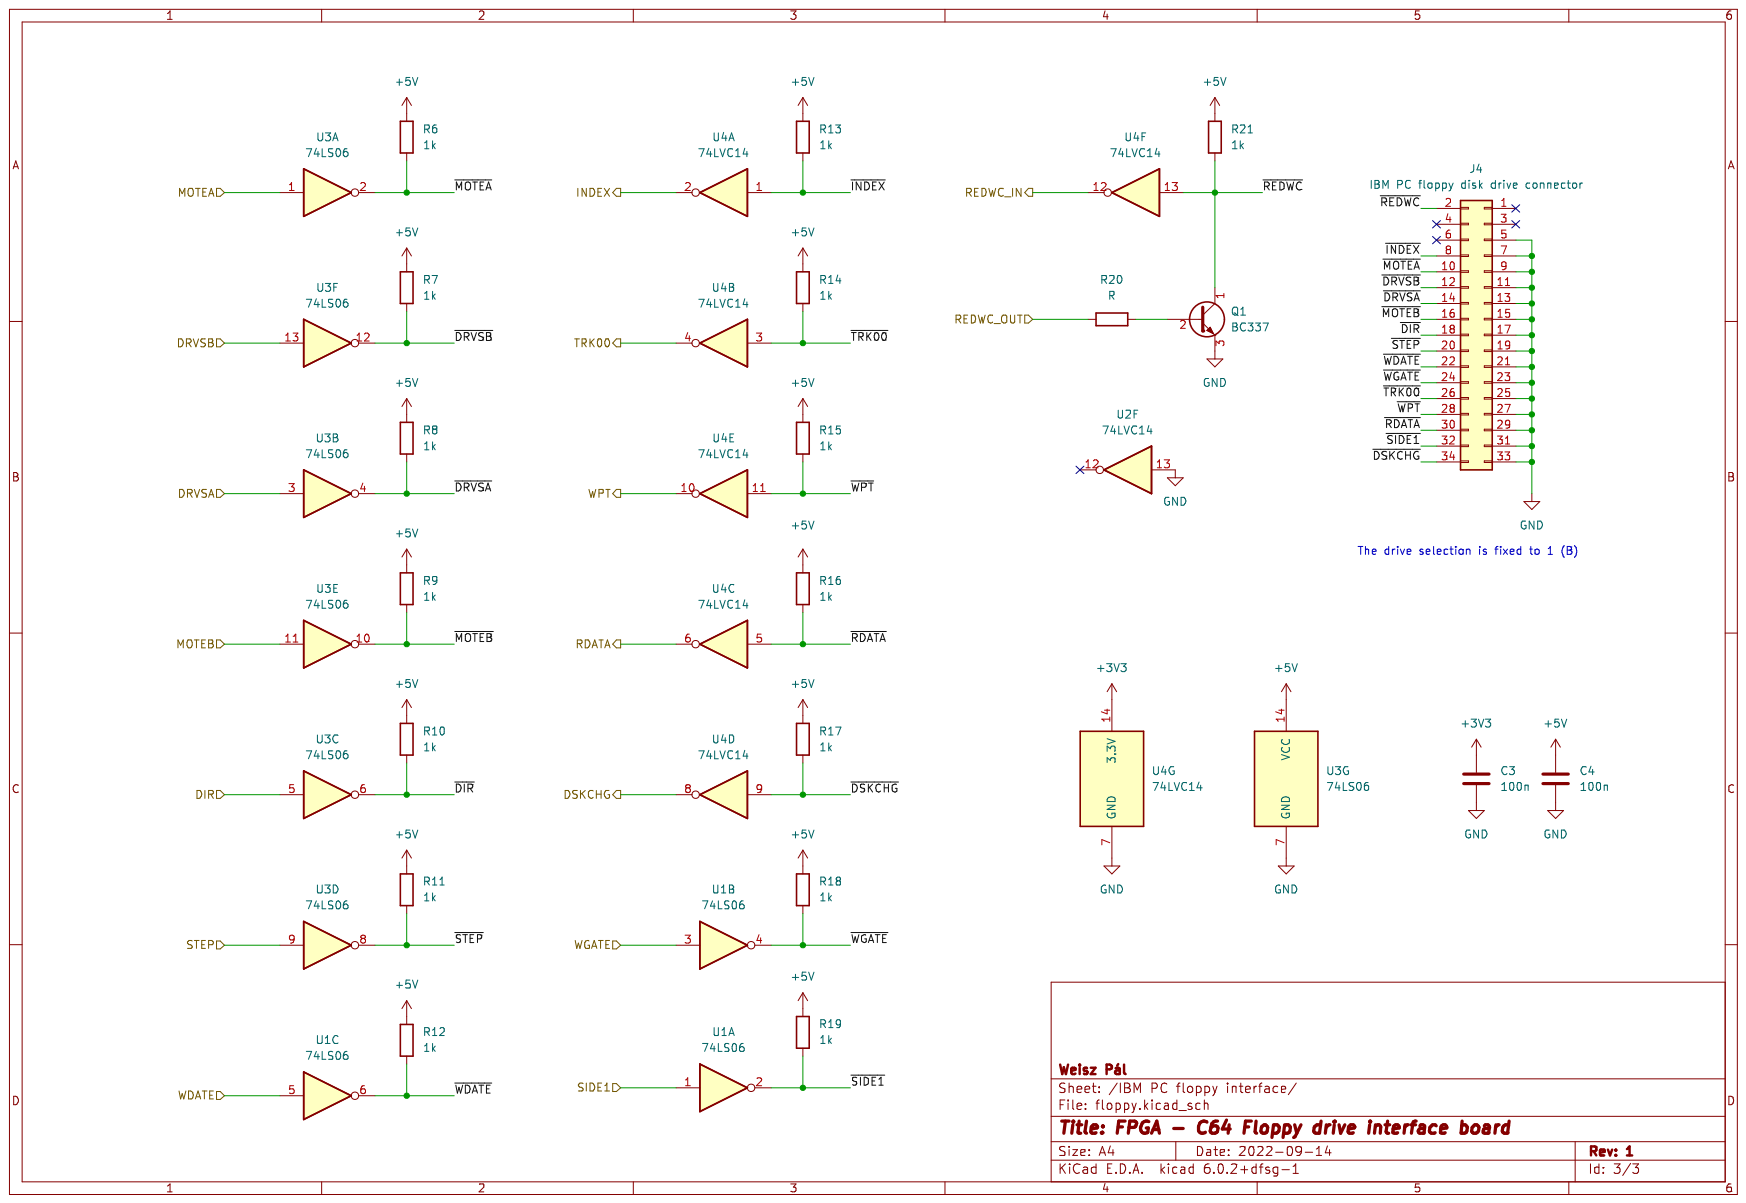
[picture p38: page 3]
