weiszpal/fpga-floppy/beszamolo/appendices/pcb.pdf

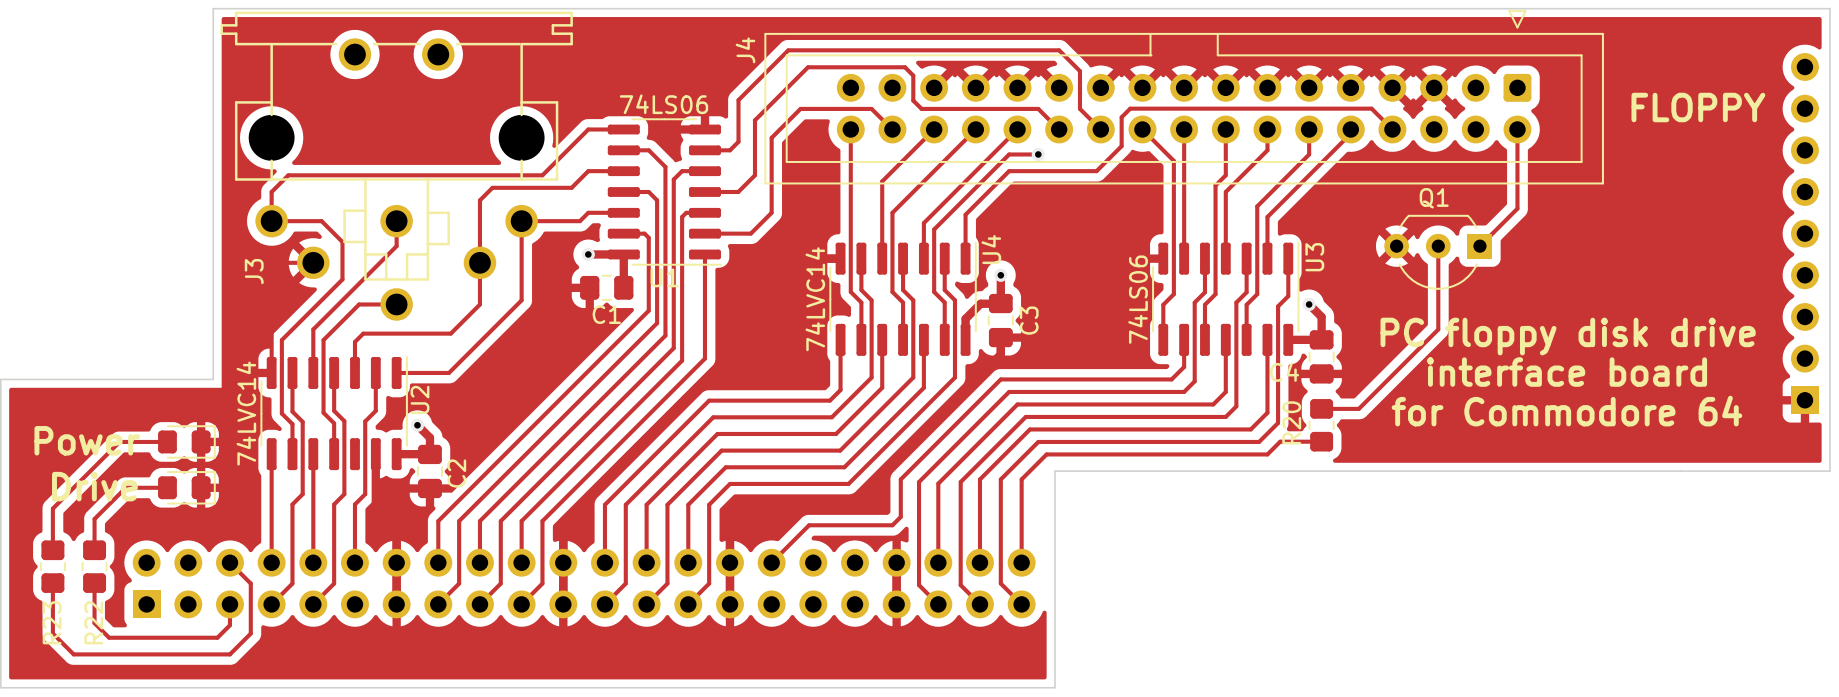
[picture p39: page 1]

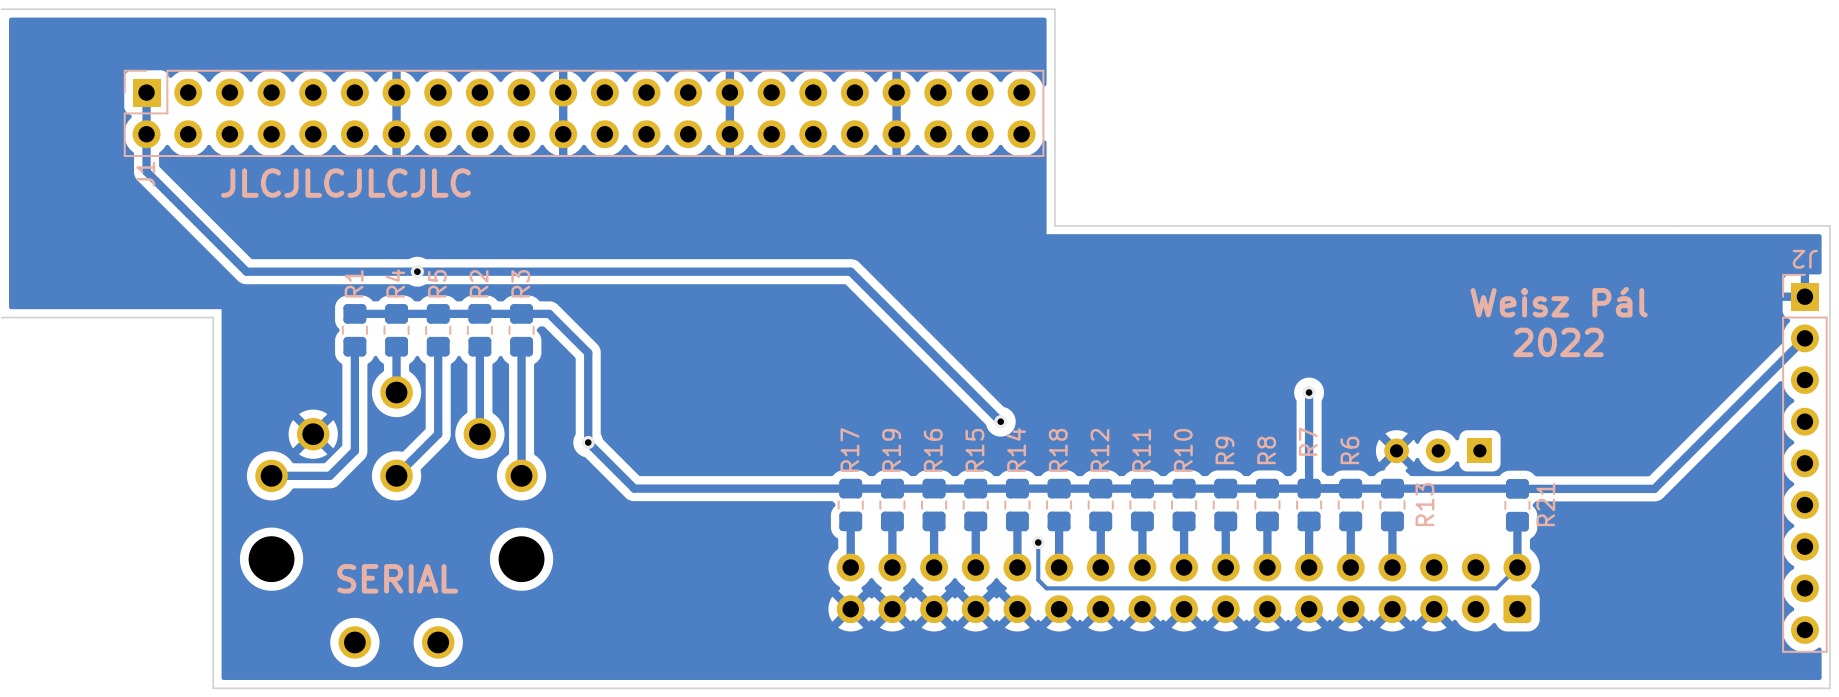
[picture p40: page 2]
