weiszpal/fpga-floppy/adapter/output/interface_board-B_Cu.pdf

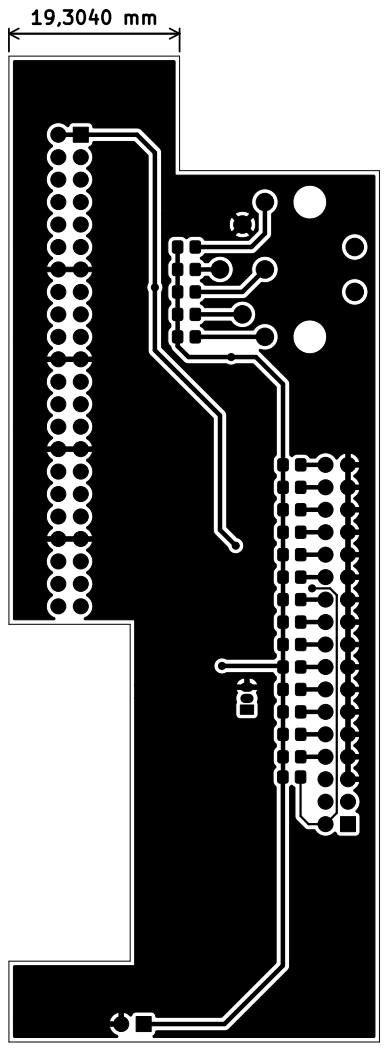
[picture p41: page 1]
