weiszpal/fpga-floppy/adapter/adapter.kicad_pcb

## KiCad design adapter/adapter.kicad_pcb (2023-01-18)

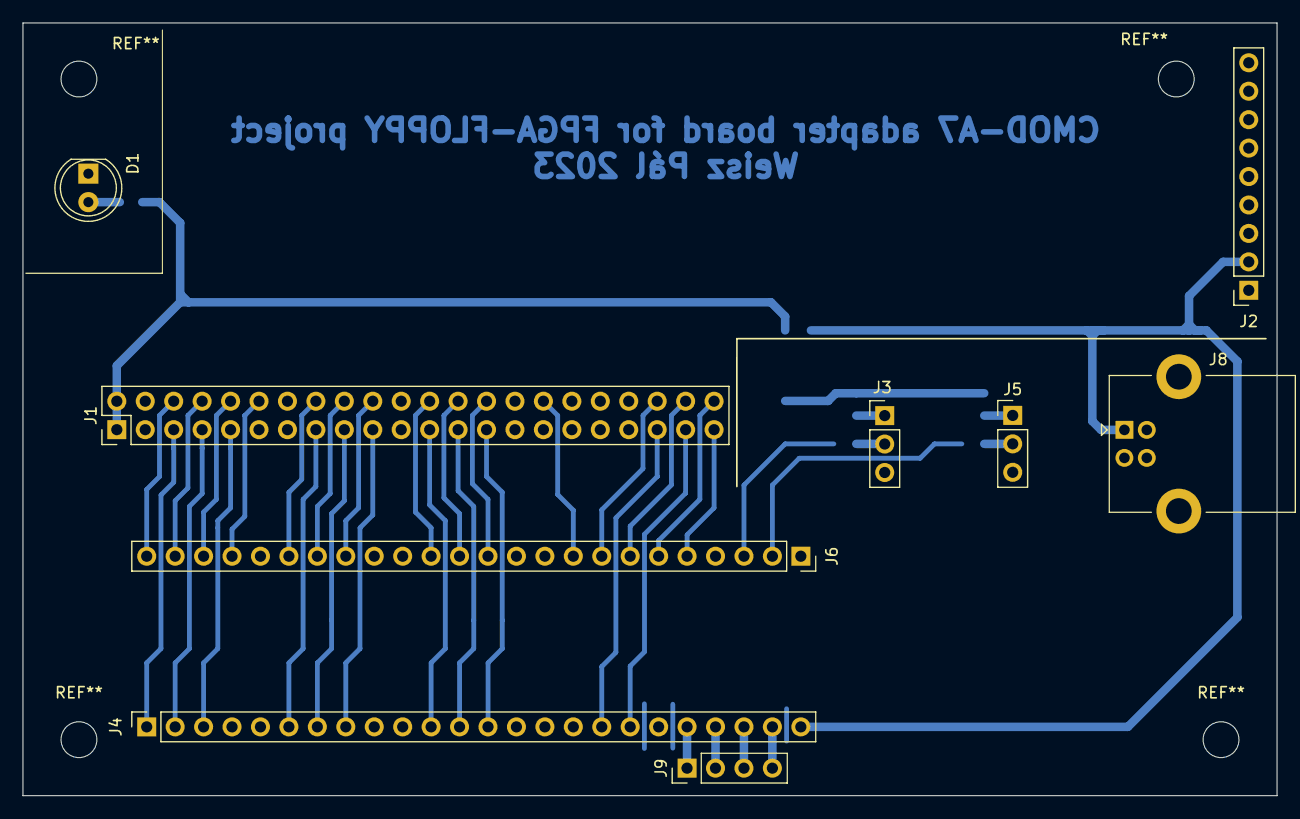
[picture p43: board adapter.kicad_pcb from above]

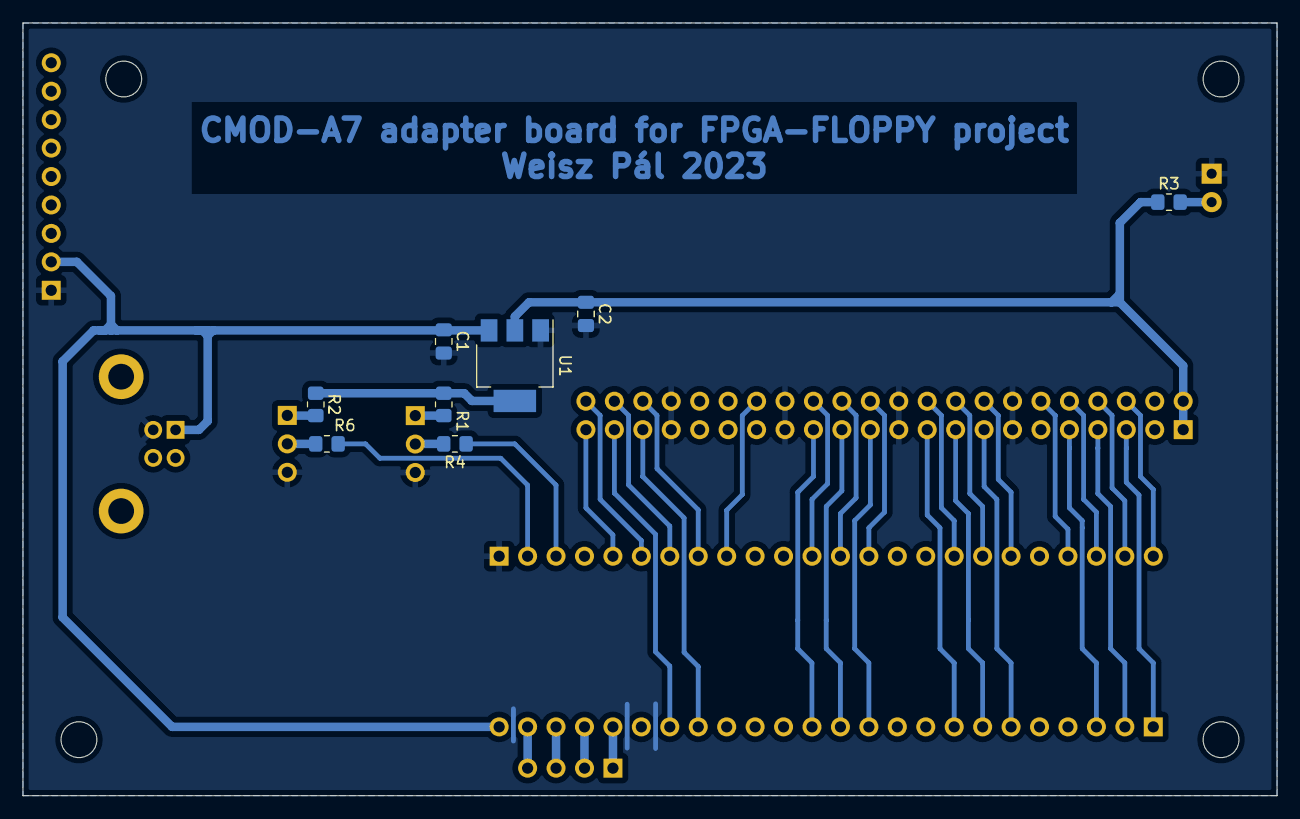
[picture p44: board adapter.kicad_pcb from below]

Board: 2 copper layers, 112.0 x 69.0 mm, 17 parts (8 on the bottom side), 40 nets.

Parts:
C1: 100n; C_0805_2012Metric_Pad1.18x1.45mm_HandSolder
C2: 10u; C_0805_2012Metric_Pad1.18x1.45mm_HandSolder
D1: LED_Filled; LED_D5.0mm
J1: FPGA_devboard; PinHeader_2x22_P2.54mm_Vertical
J2: 5V_PWR; PinSocket_1x09_P2.54mm_Vertical
J3: JP1; PinHeader_1x03_P2.54mm_Vertical
J4: CMOD-A7 1; PinSocket_1x24_P2.54mm_Vertical
J5: JP2; PinHeader_1x03_P2.54mm_Vertical
J6: CMOD-A7 2; PinSocket_1x24_P2.54mm_Vertical
J8: USB_B; USB_B_Lumberg_2411_02_Horizontal
J9: DEBUG; PinHeader_1x04_P2.54mm_Vertical
R1, R2, R4, R6: 10k; R_0805_2012Metric_Pad1.20x1.40mm_HandSolder
R3: 1k; R_0805_2012Metric_Pad1.20x1.40mm_HandSolder
U1: AP1117-33; SOT-223-3_TabPin2

Connections:
+3V3: C2.1, J1.1, J1.2, R1.1, R2.1, R3.1, U1.2 (VO)
+5V: C1.1, J2.2, J4.24, J8.1 (VBUS), U1.3 (VI)
/ACTION: J1.5, J4.1
/ATN_IN: J1.7, J4.2
/CLK_IN: J1.9, J4.3
/CLK_OUT: J1.15, J4.6
/DATA_IN: J1.12, J6.21
/DATA_OUT: J1.16, J6.19
/DIR: J1.39, J4.17
/DRVSA: J1.41, J4.18
/DRVSB: J1.42, J6.7
/DSKCHG: J1.24, J6.14
/INDEX: J1.27, J4.13
/MOTEA: J1.43, J6.5
/MOTEB: J1.40, J6.8
/PIO07: J1.17, J4.7
/PIO08: J1.19, J4.8
/PIO11: J1.23, J4.11
/PIO12: J1.25, J4.12
/PIO20: J4.20, J9.1
/PIO21: J4.21, J9.2
/PIO22: J4.22, J9.3
/PIO23: J4.23, J9.4
/PIO26: J6.2, R6.2
/PIO27: J6.3, R4.1
/PIO30: J1.44, J6.6
/PIO33: J1.32, J6.9
/PIO36: J1.28, J6.12
/PIO37: J1.26, J6.13
/PIO41: J1.20, J6.17
/PIO42: J1.18, J6.18
/PIO46: J1.10, J6.22
/PIO47: J1.8, J6.23
/PIO48: J1.6, J6.24
GND: C1.2, C2.2, D1.1 (K), J1.13, J1.14, J1.21, J1.22, J1.29, J1.30, J1.37, J1.38, J2.1, J3.3, J5.3, J6.1, J8.4 (GND), U1.1 (GND)
unnamed: D1.2 (A), R3.2
unnamed: J3.1, R1.2
unnamed: J3.2, R4.2
unnamed: J5.1, R2.2
unnamed: J5.2, R6.1
