weiszpal/fpga-floppy/interface_board/interface_board.kicad_pcb

## KiCad design interface_board/interface_board.kicad_pcb (2022-12-04)

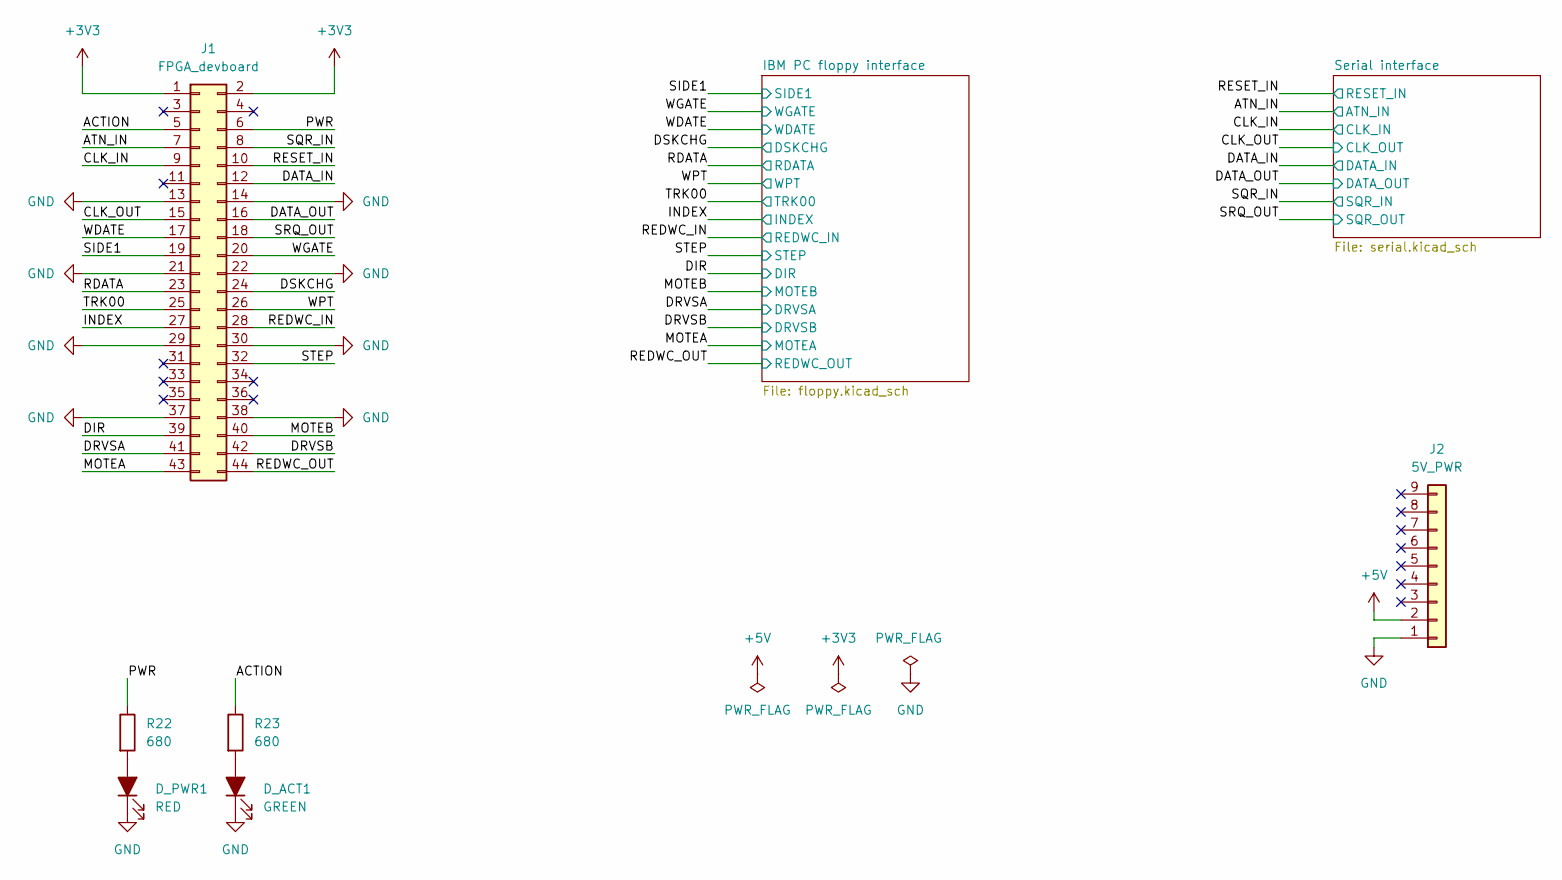
[picture p45: schematic interface_board.kicad_sch, FPGA - C64 Floppy drive interface board]

Parts:
D_ACT1: GREEN; LED_0805_2012Metric_Pad1.15x1.40mm_HandSolder
D_PWR1: RED; LED_0805_2012Metric_Pad1.15x1.40mm_HandSolder
J1: FPGA_devboard; PinSocket_2x22_P2.54mm_Vertical
J2: 5V_PWR; PinHeader_1x09_P2.54mm_Vertical
R22, R23: 680; R_0805_2012Metric_Pad1.20x1.40mm_HandSolder

Connections:
+3V3: J1.1, J1.2; also elsewhere on the board
+5V: J2.2; also elsewhere on the board
/ACTION: J1.5, R23.1
/ATN_IN: J1.7; also elsewhere on the board
/CLK_IN: J1.9; also elsewhere on the board
/CLK_OUT: J1.15; also elsewhere on the board
/DATA_IN: J1.12; also elsewhere on the board
/DATA_OUT: J1.16; also elsewhere on the board
/DIR: J1.39; also elsewhere on the board
/DRVSA: J1.41; also elsewhere on the board
/DRVSB: J1.42; also elsewhere on the board
/DSKCHG: J1.24; also elsewhere on the board
/INDEX: J1.27; also elsewhere on the board
/MOTEA: J1.43; also elsewhere on the board
/MOTEB: J1.40; also elsewhere on the board
/PWR: J1.6, R22.1
/RDATA: J1.23; also elsewhere on the board
/REDWC_IN: J1.28; also elsewhere on the board
/REDWC_OUT: J1.44; also elsewhere on the board
/RESET_IN: J1.10; also elsewhere on the board
/SIDE1: J1.19; also elsewhere on the board
/SQR_IN: J1.8; also elsewhere on the board
/SRQ_OUT: J1.18; also elsewhere on the board
/STEP: J1.32; also elsewhere on the board
/TRK00: J1.25; also elsewhere on the board
/WDATE: J1.17; also elsewhere on the board
/WGATE: J1.20; also elsewhere on the board
/WPT: J1.26; also elsewhere on the board
GND: D_ACT1.1 (K), D_PWR1.1 (K), J1.13, J1.14, J1.21, J1.22, J1.29, J1.30, J1.37, J1.38, J2.1; also elsewhere on the board
unnamed: D_ACT1.2 (A), R23.2
unnamed: D_PWR1.2 (A), R22.2

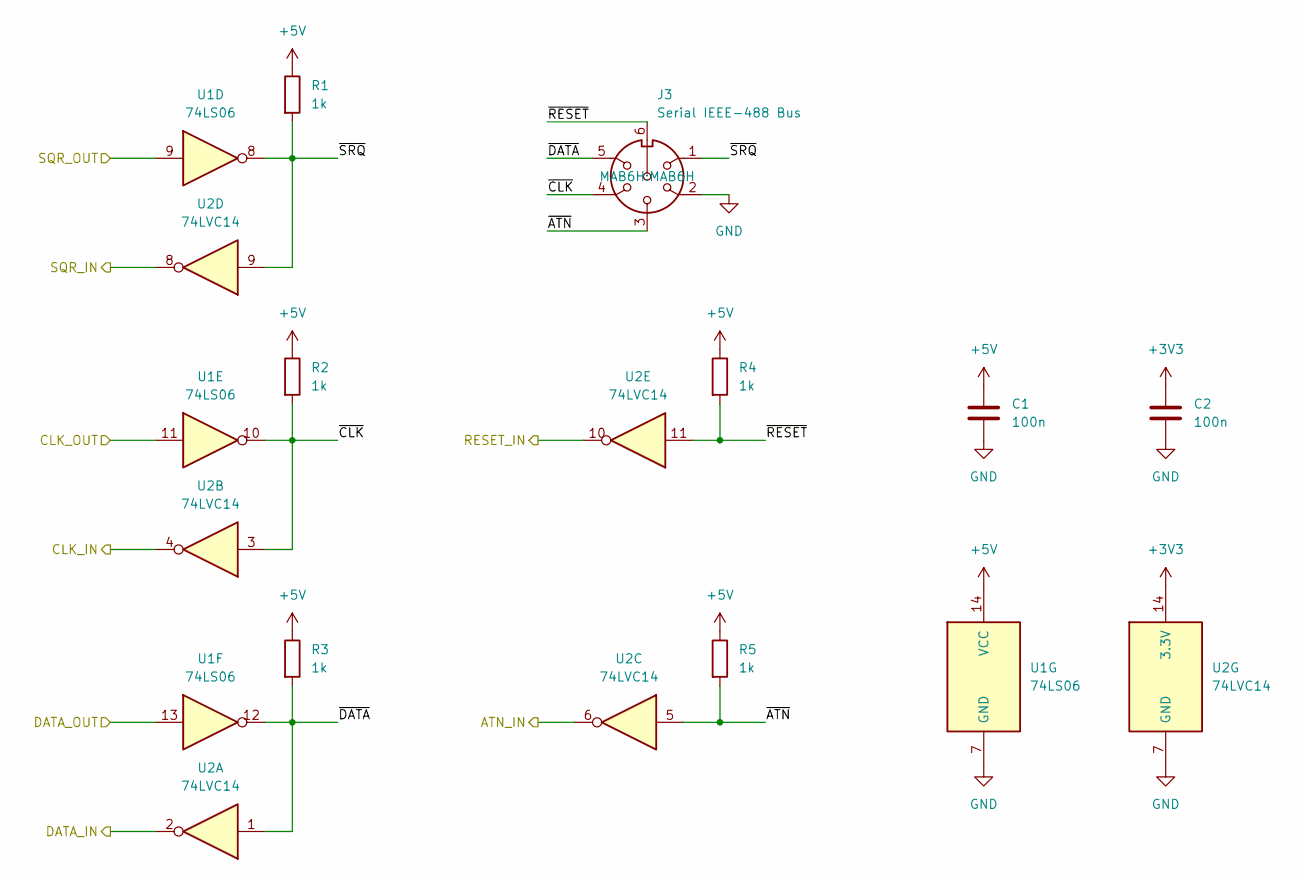
[picture p46: schematic serial.kicad_sch, FPGA - C64 Floppy drive interface board]

Parts:
C1, C2: 100n; C_0805_2012Metric_Pad1.18x1.45mm_HandSolder
J3: Serial IEEE-488 Bus; MAB6H
R1, R2, R3, R4, R5: 1k; R_0805_2012Metric_Pad1.20x1.40mm_HandSolder
U1: 74LS06; SOIC-14_3.9x8.7mm_P1.27mm
U2: 74LVC14; SOIC-14_3.9x8.7mm_P1.27mm

Connections:
+3V3: C2.1, U2.14 (3.3V); also elsewhere on the board
+5V: C1.1, R1.1, R2.1, R3.1, R4.1, R5.1, U1.14 (VCC); also elsewhere on the board
/ATN_IN: U2.6; also elsewhere on the board
/CLK_IN: U2.4; also elsewhere on the board
/CLK_OUT: U1.11; also elsewhere on the board
/DATA_IN: U2.2; also elsewhere on the board
/DATA_OUT: U1.13; also elsewhere on the board
/RESET_IN: U2.10; also elsewhere on the board
/SQR_IN: U2.8; also elsewhere on the board
/SRQ_OUT: U1.9; also elsewhere on the board
/Serial interface/~ATN: J3.3, R5.2, U2.5
/Serial interface/~CLK: J3.4, R2.2, U1.10, U2.3
/Serial interface/~DATA: J3.5, R3.2, U1.12, U2.1
/Serial interface/~RESET: J3.6, R4.2, U2.11
/Serial interface/~SRQ: J3.1, R1.2, U1.8, U2.9
GND: C1.2, C2.2, J3.2, U1.7 (GND), U2.7 (GND); also elsewhere on the board

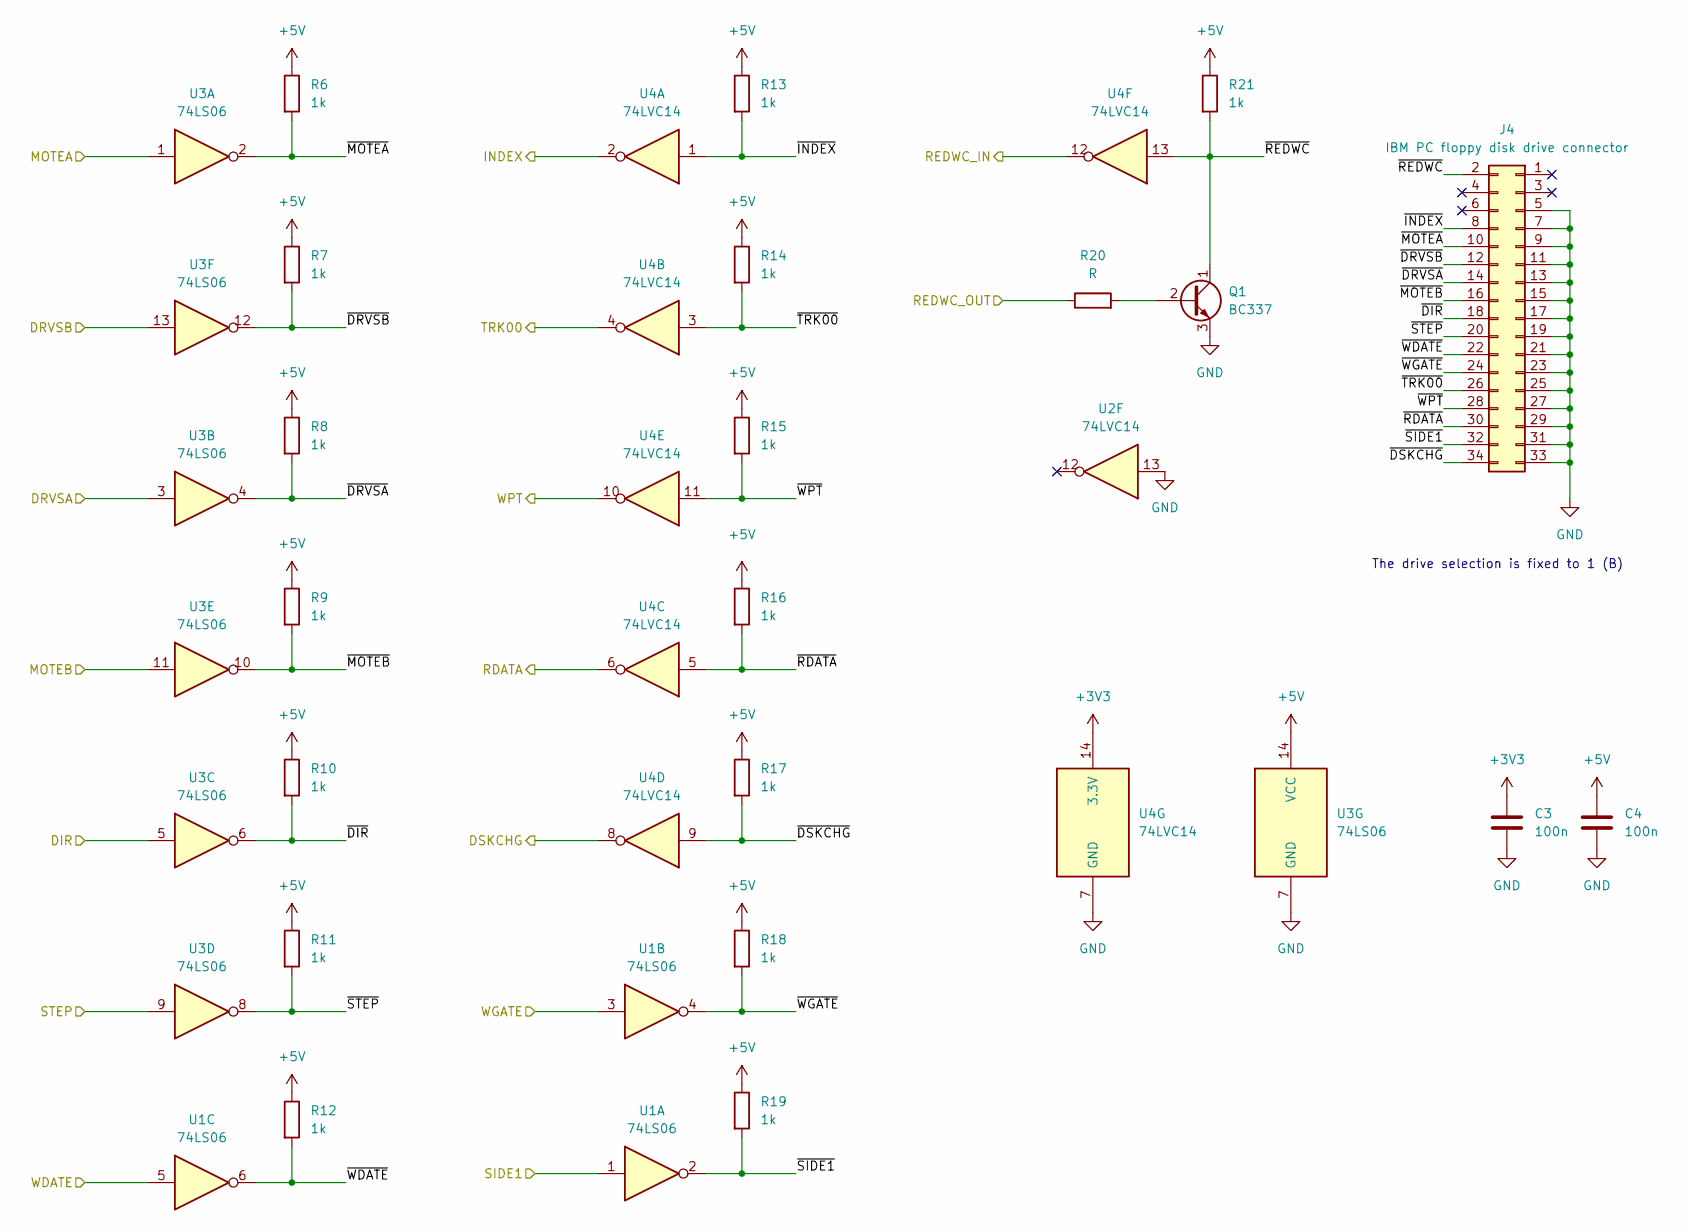
[picture p47: schematic floppy.kicad_sch, FPGA - C64 Floppy drive interface board]

Parts:
C3, C4: 100n; C_0805_2012Metric_Pad1.18x1.45mm_HandSolder
J4: IBM PC floppy disk drive connector; IDC-Header_2x17_P2.54mm_Vertical
Q1: BC337; TO-92_Inline_Wide
R6, R7, R8, R9, R10, R11, R12, R13, R14, R15, R16, R17, R18, R19, R21: 1k; R_0805_2012Metric_Pad1.20x1.40mm_HandSolder
R20: R; R_0805_2012Metric_Pad1.20x1.40mm_HandSolder
U1, U3: 74LS06; SOIC-14_3.9x8.7mm_P1.27mm
U2, U4: 74LVC14; SOIC-14_3.9x8.7mm_P1.27mm

Connections:
+3V3: C3.1, U4.14 (3.3V); also elsewhere on the board
+5V: C4.1, R6.1, R7.1, R8.1, R9.1, R10.1, R11.1, R12.1, R13.1, R14.1, R15.1, R16.1, R17.1, R18.1, R19.1, R21.1, U3.14 (VCC); also elsewhere on the board
/DIR: U3.5; also elsewhere on the board
/DRVSA: U3.3; also elsewhere on the board
/DRVSB: U3.13; also elsewhere on the board
/DSKCHG: U4.8; also elsewhere on the board
/IBM PC floppy interface/~DIR: J4.18, R10.2, U3.6
/IBM PC floppy interface/~DRVSA: J4.14, R8.2, U3.4
/IBM PC floppy interface/~DRVSB: J4.12, R7.2, U3.12
/IBM PC floppy interface/~DSKCHG: J4.34, R17.2, U4.9
/IBM PC floppy interface/~INDEX: J4.8, R13.2, U4.1
/IBM PC floppy interface/~MOTEA: J4.10, R6.2, U3.2
/IBM PC floppy interface/~MOTEB: J4.16, R9.2, U3.10
/IBM PC floppy interface/~RDATA: J4.30, R16.2, U4.5
/IBM PC floppy interface/~REDWC: J4.2, Q1.1 (C), R21.2, U4.13
/IBM PC floppy interface/~SIDE1: J4.32, R19.2, U1.2
/IBM PC floppy interface/~STEP: J4.20, R11.2, U3.8
/IBM PC floppy interface/~TRK00: J4.26, R14.2, U4.3
/IBM PC floppy interface/~WDATE: J4.22, R12.2, U1.6
/IBM PC floppy interface/~WGATE: J4.24, R18.2, U1.4
/IBM PC floppy interface/~WPT: J4.28, R15.2, U4.11
/INDEX: U4.2; also elsewhere on the board
/MOTEA: U3.1; also elsewhere on the board
/MOTEB: U3.11; also elsewhere on the board
/RDATA: U4.6; also elsewhere on the board
/REDWC_IN: U4.12; also elsewhere on the board
/REDWC_OUT: R20.1; also elsewhere on the board
/SIDE1: U1.1; also elsewhere on the board
/STEP: U3.9; also elsewhere on the board
/TRK00: U4.4; also elsewhere on the board
/WDATE: U1.5; also elsewhere on the board
/WGATE: U1.3; also elsewhere on the board
/WPT: U4.10; also elsewhere on the board
GND: C3.2, C4.2, J4.5, J4.7, J4.9, J4.11, J4.13, J4.15, J4.17, J4.19, J4.21, J4.23, J4.25, J4.27, J4.29, J4.31, J4.33, Q1.3 (E), U2.13, U3.7 (GND), U4.7 (GND); also elsewhere on the board
unnamed: Q1.2 (B), R20.2

Notes on the sheet:
The drive selection is fixed to 1 (B)

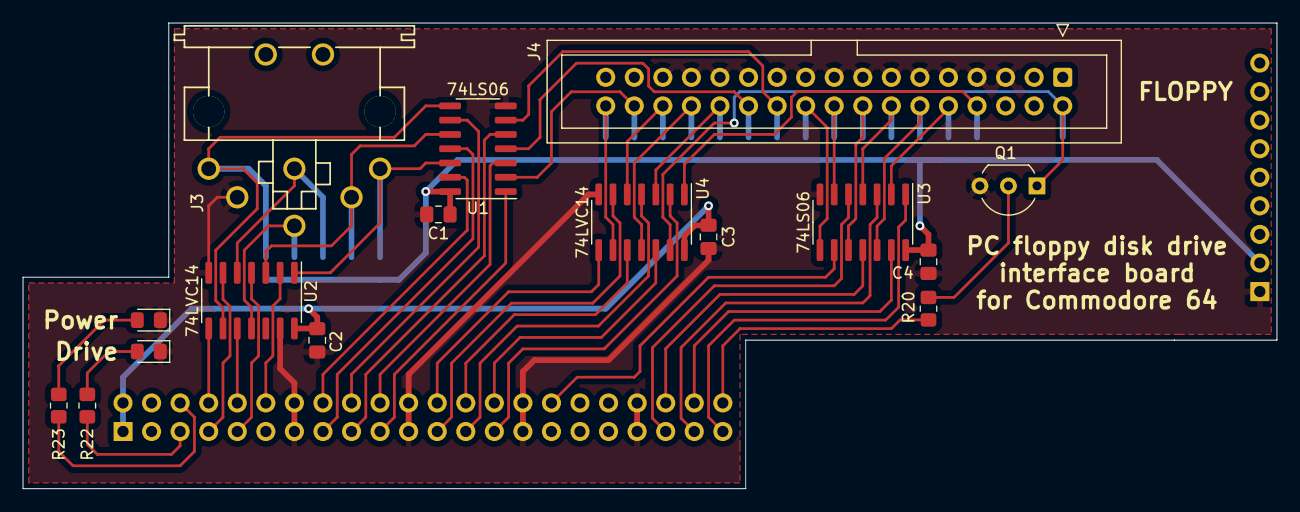
[picture p48: board interface_board.kicad_pcb from above]

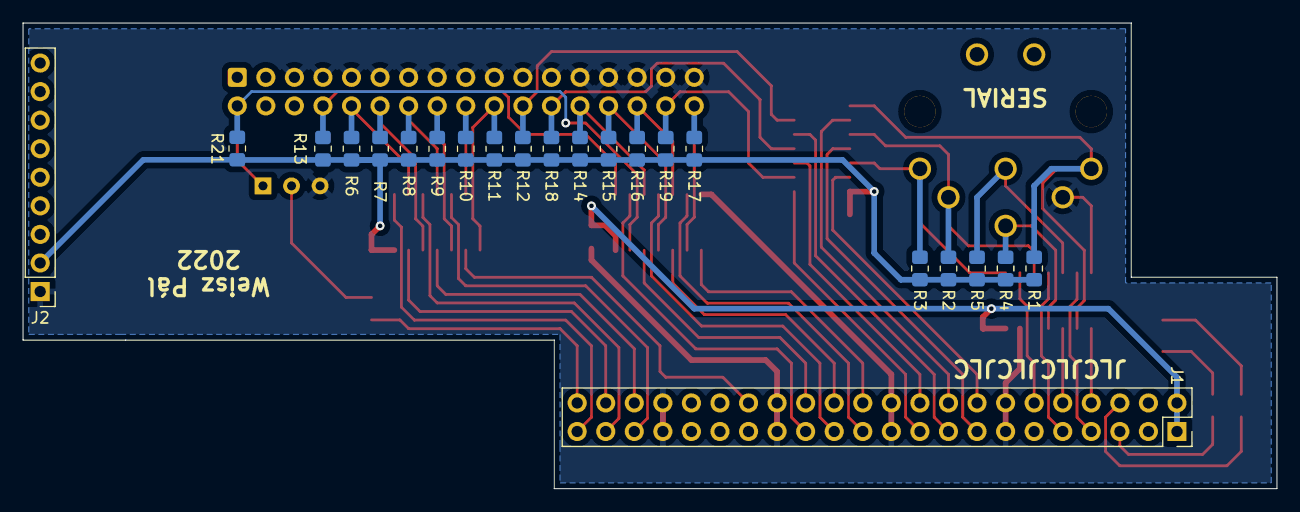
[picture p49: board interface_board.kicad_pcb from below]

Board: 2 copper layers, 111.5 x 41.4 mm, 38 parts (22 on the bottom side), 52 nets.
