weiszpal/fpga-floppy/fpga_project/rtl/top_module.v

	`timescale 1ns / 1ps
	//////////////////////////////////////////////////////////////////////////////////
	// Company: 
	// Engineer: 
	// 
	// Create Date:    14:11:12 10/05/2022 
	// Design Name: 
	// Module Name:    top_module 
	// Project Name: 
	// Target Devices: 
	// Tool versions: 
	// Description: 
	//
	// Dependencies: 
	//
	// Revision: 
	// Revision 0.01 - File Created
	// Additional Comments: 
	//
	//////////////////////////////////////////////////////////////////////////////////
	module top_module(
	
		// LEDS
		output	PWR_LED,			//wired
		output	ACTION_LED,		//wired

		// SERIAL PORT
		input		RESET_IN,		//wired (to ~rst)
		input		ATN_IN,			//wired
		input		CLK_IN,			//wired
		output	CLK_OUT,			//wired
		input		DATA_IN,			//wired
		output	DATA_OUT,		//wired
		input		SRQ_IN,			//wired
		output	SRQ_OUT,			//wired

		// FLOPPY DRIVE
		output 	SIDE1,			//wired
		output 	WGATE,			//wired
		output 	WDATE,			//wired
		input 	DSKCHG,			//wired
		input 	RDATA,			//wired
		input 	WPT,				//wired
		input 	TRK00,			//wired
		input 	INDEX,			//wired
		input 	REDWC_IN,		//not used
		output 	STEP,				//wired
		output 	DIR,				//wired
		output 	MOTEB,			//wired
		output 	DRVSA,			//not used
		output 	DRVSB,			//wired
		output 	MOTEA,			//not used	
		output 	REDWC_OUT,		//not used

		// DEVICE NUMBER SELECT
		input 	SW0,
		input 	SW1,
		
		//debug signals for inspection
		output 	DBG_MO,
		output 	DBG_PI2,
		output	DBG_RST,
		output	DBG_RDY,
		
		// MAIN CLOCK SIGNAL
		input 	fpga_clk			// 50 MHz to FPGA logic
	);

	//debug signals
	assign DBG_RST = rstn;
	assign DBG_PI2 = phi_2; //clk_tap;
	assign DBG_RDY = RDY;

	// Clock signals
	wire clk;			// 16 MHz system clock
	wire phi_0;			// 2 MHz to CPU
	wire phi_2;			// 2 MHz to system
	wire clk_tap;		// PLL output to measure (16 MHz intended)
	wire clk_sel_fdc;	// symmetrica 2MHz clock for CSn_FDC

	// Bus signals
	wire rstn;			// active low reset signal
	wire irqn;
	wire rw;
	wire [15:0] addr;
	wire [7:0] data_out_cpu;
	reg [7:0] data_in_cpu;

	// Other auxiliary signals
	reg RDY;
	
	initial RDY <= 1'b1;
	always @(posedge clk) begin
		if(!rstn)
			RDY <= 1'b1;
		else begin
			case({MOTEB, INDEX})	//motor on? index?
				2'b00: RDY <= 1'b1;
				2'b01: RDY <= 1'b1;
				2'b10: RDY <= RDY;
				2'b11: RDY <= 1'b0;
			endcase
		end
	end
	
	// Chip select signals and data_out lines
	wire CSn_RAM;
	wire CSn_ROM;
	wire CSn_CIA;
	wire CSn_FDC;
	
	wire [7:0] DO_RAM;
	wire [7:0] DO_ROM;
	wire [7:0] DO_CIA;
	wire [7:0] DO_FDC;
	
	always @(CSn_RAM or CSn_ROM or CSn_CIA or CSn_FDC or DO_RAM or DO_ROM or DO_CIA or DO_FDC) begin
      case ({CSn_RAM, CSn_ROM, CSn_CIA, CSn_FDC})
         4'b0111 : data_in_cpu <= DO_RAM;
         4'b1011 : data_in_cpu <= DO_ROM;
         4'b1101 : data_in_cpu <= DO_CIA;
         4'b1110 : data_in_cpu <= DO_FDC;
			default data_in_cpu <= 8'hFF; //was 8'bz;
      endcase
   end
	
	assign CSn_RAM = addr[15:13]!=3'b000;						//address range: $0000-$1FFF (U6)
	assign CSn_ROM = !(rw && addr[15]);							//address range: $8000-$FFFF (U7)
	assign CSn_CIA = addr[15:13]!=3'b010;						//address range: $4000 (U6)
	assign CSn_FDC = !(addr[15:13]==3'b011);					//address range: $6000 (U6)

	wire DATA_OUT_AUX;
	wire ATN_ACK;
	wire SP_OUT;
	wire CNT_OUT;
	wire SIDE0;
	wire MOTOR;
	wire DIRC;

	wire [7:0] pa_in;
	wire [7:0] pa_out;
	wire [7:0] pb_in;
	wire [7:0] pb_out;
	
	//pb_in[0] = DATA_IN;
	//pb_out[1] = DATA_OUT_AUX;
	//pb_in[2] = CLK_IN;
	//pb_out[3] = CLK_OUT;
	//pb_out[4] = ATN_ACK;
	//pb_out[5] unused (fast_ser_dir)
	//pb_in[6] = ~WPT;
	//pb_in[7] = ATN_IN; 
	
	//pa_out[0] = SIDE0;
	//pa_in[1] = RDY;
	//pa_out[2] = MOTOR;
	//pa_in[3] = SW0;
	//pa_in[4] = SW1;
	//pa_out[5] = PWR_LED;
	//pa_out[6] = ACTION_LED;
	//pa_in[7] = ~DSKCHG;
	
	// FUNCTIONAL MODULES
	iecdrv_mos8520 CIA (
		.clk(clk),
		.phi2_p(phi_2), // Phi 2 positive edge
		.phi2_n(~phi_2), // Phi 2 negative edge
		.res_n(rstn),
		.cs_n(CSn_CIA),
		.rw(rw),
		.rs(addr[3:0]),
		.db_in(data_out_cpu),
		.db_out(DO_CIA),
		.irq_n(irqn),
		.tod(1'b1),

		.pa_in(pa_in),
		.pa_out(pa_out),

		.pb_in(pb_in),
		.pb_out(pb_out),

		.flag_n(~ATN_IN),
		.pc_n(),	//not connected

		.sp_in(~DATA_IN),
		.sp_out(SP_OUT),
		.cnt_in(~SRQ_IN),
		.cnt_out(CNT_OUT)
	);

	assign pb_in[0] = DATA_IN;
	assign DATA_OUT_AUX = pb_out[1];
	assign pb_in[2] = CLK_IN;
	assign CLK_OUT = pb_out[3];
	assign ATN_ACK = pb_out[4];
	assign pb_in[6] = ~WPT;
	assign pb_in[7] = ATN_IN; 
	
	assign SIDE0 = pa_out[0];
	assign pa_in[1] = RDY;
	assign MOTOR = pa_out[2];
	assign pa_in[3] = SW0;
	assign pa_in[4] = SW1;
	assign PWR_LED = pa_out[5];
	assign ACTION_LED = pa_out[6];
	assign pa_in[7] = ~DSKCHG;

	//unused CIA inputs
	assign pa_in[0] = pa_out[0];
	assign pa_in[2] = pa_out[2];
	assign pa_in[5] = pa_out[5];
	assign pa_in[6] = pa_out[6];
	
	assign pb_in[1] = pb_out[1];
	assign pb_in[3] = pb_out[3];
	assign pb_in[4] = pb_out[4];
	assign pb_in[5] = 1'b1;
 
	assign DATA_OUT = (~SP_OUT) || DATA_OUT_AUX || (ATN_IN && ATN_ACK);
	assign SRQ_OUT = ~CNT_OUT;
	assign SIDE1 = ~SIDE0;
	assign MOTEB = ~MOTOR;
	assign DRVSB = 1'b1;
	assign DIR = DIRC; //?polarity
	
	// Unused pins:
	assign MOTEA = 1'b0;
	assign DRVSA = 1'b0;
	assign REDWC_OUT = 1'b0;

	// Disk driver
	WF1772IP_TOP FDC (
		.CLK(clk),
		.MRn(rstn),
		.CSn(CSn_FDC),
		.RWn(rw),
		.A1(addr[1]),
		.A0(addr[0]),
		.DATA_IN(data_out_cpu),
		.DATA_OUT(DO_FDC),
		.RDn(~RDATA),
		.TR00n(~TRK00),
		.IPn(~INDEX),
		.WPRTn(~WPT),
		.DDEn(1'b0),
		.HDTYPE(1'b0),	//MFM, double density (see wf1772ip_digital_pll)
		.MO(DBG_MO),			//not connected
		.WG(WGATE),
		.WD(WDATE),
		.STEP(STEP),
		.DIRC(DIRC),
		.DRQ(),			//not connected
		.INTRQ()			//not connected
	);

	// Processor
	chip_6502 CPU (
		.clk(phi_0),					// CPU clock 
		.rstn(rstn),					// reset signal
		.address(addr[15:0]),		// address bus
		.data_in(data_in_cpu),		// data in, read bus
		.data_out(data_out_cpu),	// data out, write bus
		.rw(rw),							// write enable
		.irqn(irqn)						// interrupt request	
	);
	
	// RAM module
	SRAM_8K SRAM (
		.clk(clk), 
		.addr(addr[12:0]), 
		.data_in(data_out_cpu), 
		.data_out(DO_RAM), 
		.rw(rw),				 			//WE signal sync (U6) (was: rw && phi_2)
		.en(CSn_RAM)
	);

	// ROM module
	ROM_23256 ROM (
		.clk(clk), 
		.addr(addr[14:0]), 
		.data(DO_ROM), 
		.oen(CSn_ROM)
	);

	// Clock generator
	clock_gen sysclk (
		.reset(1'b0),//!rstn),
		.fpga_clk(fpga_clk),
		.clk(clk),
		.phi_0(phi_0),
		.phi_2(phi_2),
		.clk_tap(clk_tap),
		.clk_sel_fdc(clk_sel_fdc)
	);

	assign rstn = ~RESET_IN;

endmodule
