weiszpal/fpga-floppy/(commit log)

2022-09-04 Add empty kicad project
    [interface_board.kicad_pcb, interface_board.kicad_sch]
2022-09-07 Add interface board PCB design
    [floppy.kicad_sch, interface_board.kicad_pcb, interface_board.kicad_sch, serial.kicad_sch]
2022-09-14 Finish interface board PCB
    [floppy.kicad_sch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]
2022-10-03 Complete and test pin configuration file
2022-10-11 Minor cleanup in top module, add ucf file
    [interface_board.kicad_sch]
2022-10-17 CPU sort of works with improved clock generator
    [SERLIB.OBJ]
2022-10-19 Add external logic analyzer measurement, found weird bug
    [floppy_testbench.v, top_module.v]
2022-11-04 Add 6502 emulator written in C and fix B flag logic in T65 core implementation
    [T65.vhd, clock_gen.v, floppy_testbench.v, main.c, top_module.v]
2022-11-20 Record several measurements
    [floppy_readstatus_bug.csv, sdrive_readstatus.csv]
2022-11-24 Fix DSKCHG pin assignment in ucf file, flip ribbon cable connector on schematic
    [interface_board.kicad_sch]
2022-12-04 Add schematics for appendix, add sketch to diploma, simulate startup in isim
    [floppy.kicad_sch, interface_board.kicad_pcb, interface_board.kicad_sch, serial.kicad_sch]
2022-12-05 Add some more debug features to emulator, fix clock testbench for PLL testing
    [clock_test.v, main.c]
2022-12-15 Add interface board and digital designing to documentation
2023-01-18 Add adapter board design
    [adapter-B_Cu.gbr, adapter-B_Mask.gbr, adapter-B_Silkscreen.gbr, adapter-Edge_Cuts.gbr, adapter-F_Cu.gbr, adapter-F_Mask.gbr, adapter-F_Silkscreen.gbr, adapter-PTH.drl]
